bear24rw/sggoc/doc/weekly_updates/update_02_20121012.tex

\documentclass[12pt]{article}
\usepackage[margin=0.75in]{geometry}
\usepackage{titling}
\usepackage[compact]{titlesec}
\usepackage{url}
\usepackage[pdfborder={0 0 0}]{hyperref}

\setlength{\droptitle}{-4em}
\addtolength{\droptitle}{-4pt}

\title{Sega Game Gear on a Chip \\ Weekly Update \#2}
\author{ Max Thrun | Samir Silbak }

\begin{document}
\maketitle

\section*{Accomplished}
\begin{itemize}
    \item Continued work on UART ROM flasher to load game roms into the flash memory chip.
    \item Continued work on VGA timing module.
\end{itemize}

\section*{Planned}
\begin{itemize}
    \item Finish UART ROM flasher.
    \item Look into the Sega Memory Mapper\cite{mapper} functionality and start writing a module to reimplement it.
    \item Finish the VGA timing  module.
\end{itemize}

\section*{Outstanding Issues}
None at this time.

\vspace{.1in}
\begin{thebibliography}{9}
    \bibitem{mapper} \url{http://www.smspower.org/Development/Mappers?from=Development.Mapper}
\end{thebibliography}

\end{document}
