bear24rw/sggoc/doc/final_proposal_joined.pdf

## Final Project Proposal

Max Thrun — Samir Silbak

October 26, 2012

## Project Title

Sega Game Gear on a Chip (SGGoC)

## Problem Statement

As computer systems age it is often impossible to keep physically maintaining them. For many old systems you cannot buy replacement parts and finding people who have the skill to repair the original hardware is difficult. Recently, with the advent of Field Programmable Gate Arrays (FPGAs), it is now possible to completely recreate all the original hardware and reimplement everything in a hardware description language (HDL). The advantages of doing this is that you can replace a huge multi chip solution with a single chip implementation. Doing so also helps future-proof the system as the HDL is portable and standardized. Our project is a case study in the process of reimplementing the Sega Game Gear gaming console, which can be viewed as a specialized computer system, in HDL on a FPGA. From our project we hope to educate and provide people with a case study on the process and implementation strategies that go into recreating these old computer systems.

## Project Requirements

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

## Functional Description

Our final implementation will be a fully functioning Sega Game Gear running on an Altera DE-1 FPGA development board. Video output will be to a computer monitor via VGA and input will be through some type of retro gaming controller, such as the Sega Genesis controllers. Any Sega Game Gear ROM which uses the Sega mapper (we do not plan on implementing less common mappers) will be playable. Functional diagrams showing the interaction of the submodules as well the high level interaction with the user is shown on the following pages.

## Team Participants

Max Thrun - FPGAs / computer architecture / programming
Samir Silbak - Linux / embedded systems / software development

## Advisor

Carla Purdy (carla.purdy@uc.edu)

1

## SGGoC External Block Diagram

### SGGoC

Computer Monitor | Speakers | Sega Controller

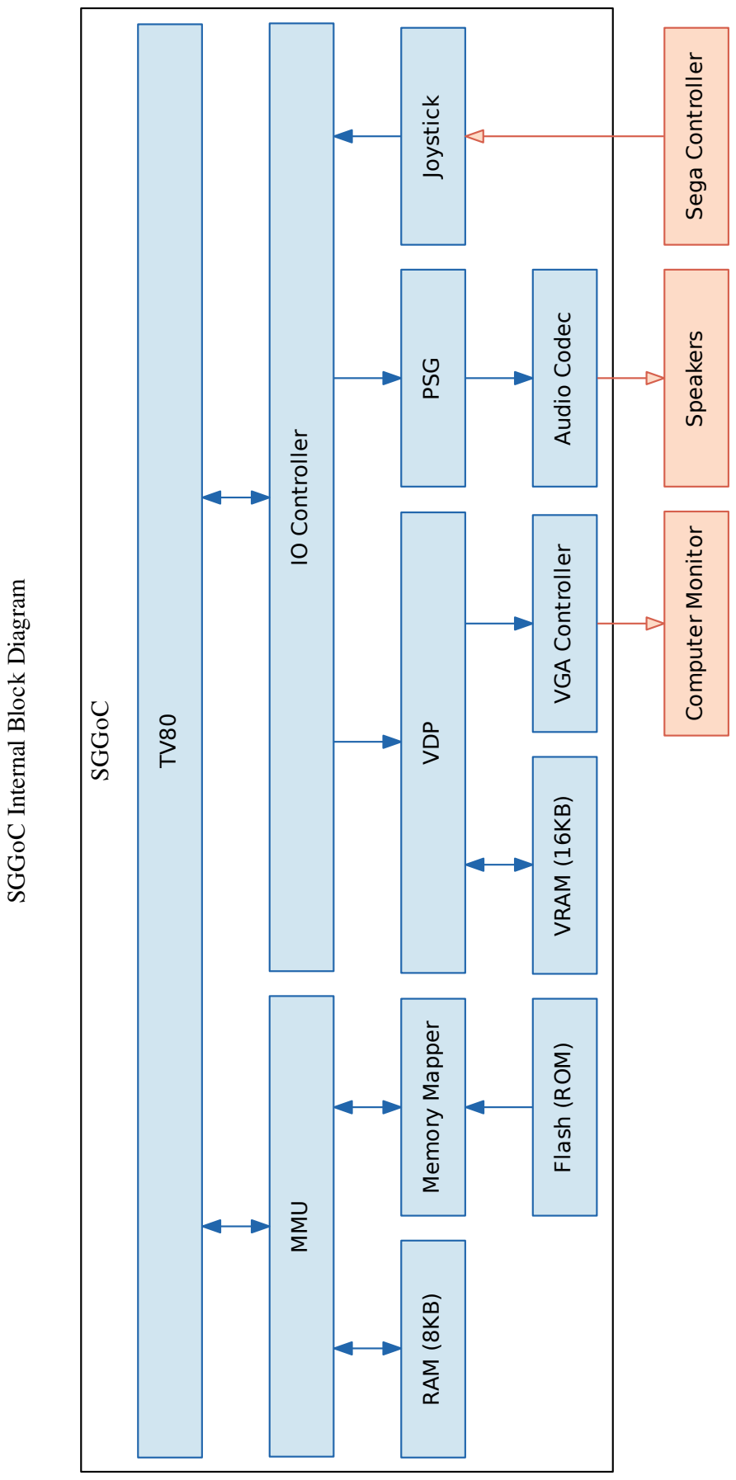
[picture p25: figure]
SGGoC Internal Block Diagram; SGGoC; MMU IO Controller; Flash (ROM) VGA Controller VRAM (16KB); Computer Monitor; Audio Codec; Sega Controller Speakers

Memory Mapper RAM (8KB) Joystick PSG VDP

Today's Date: Tuesday

(vertical red line)

Project Lead:

Start Date: Monday

[42] First Day of Week (Mon=2): 2

WBS Tasks

Task

Lead Start End

### 1 Research 10/1/12 10/6/12 6 99% 5 5 1

1.1

Find and gather

technical information on

the Game Gear

Hardware Max, Samir 10/1/12 10/1/12 1 95% 1 0 1

1.2

Determine how to

interface with Flash

memory Max 10/2/12 10/3/12 2 100% 2 2 0

1.3

Determine how to

interface with VGA Samir 10/4/12 10/5/12 2 100% 2 2 0

1.4 Start GitHub Project Max, Samir 10/6/12 10/6/12 1 100% 0 1 0

### 2 Implementation 10/6/12 11/13/12 39 11% 27 4 35

2.1 UART ROM flasher Max 10/6/12 10/8/12 3 100% 1 3 0

2.2 VGA timing module Samir 10/9/12 10/10/12 2 50% 2 1 1
2.3 Sega Memory Mapper 10/11/12 10/13/12 3 5% 2 0 3

2.4 Video Display Processor 10/15/12 11/13/12 30 0% 22 0 30 10/23/2012

Max Thrun, Samir Silbak

10/1/2012

Gantt Chart Template by Vertex42.com © 2008 Vertex42 LLC
