bear24rw/sggoc/doc/design_report/cover.pdf

### SECS Senior Design

Sega Game Gear on a Chip
Final Design Report

Date: 19/04/2013

University of Cincinnati, Ohio
