bear24rw/sggoc/doc/first_tdr_slides/design_slides.pdf

## Sega Game Gear on a Chip

Max Thrun — Samir Silbak

University of Cincinnati

Fall 2012

Sega Game Gear on a Chip | 1 / 27

## Agenda

- Introduction / Problem Description
- The Sega Game Gear
- Prototyping Platform
- Design Strategy & Process
- Component Descriptions
- Testing Strategy / Assessment Metrics
- Issues of Concern
Sega Game Gear on a Chip | Agenda | 2 / 27

## Underlying Goal

## Reimplement all the digital components of a legacy computer system in a FPGA

Sega Game Gear on a Chip | Introduction | 3 / 27

## Purpose

Why?
- Maintainability - You can no longer buy parts to service legacy computer systems

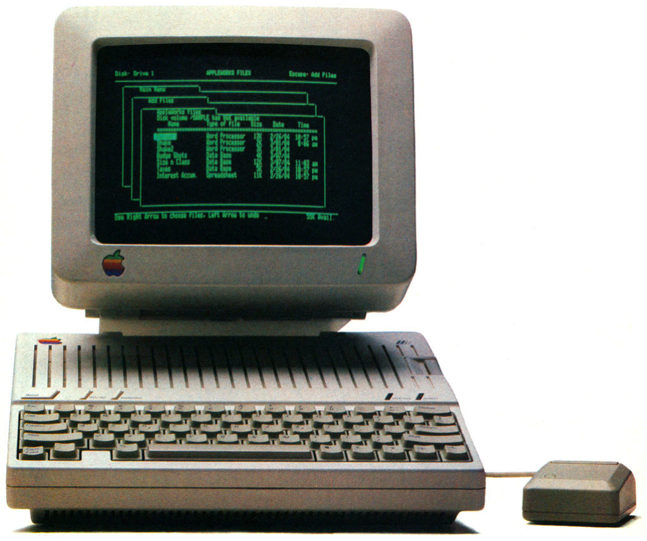
[picture p39: figure]

- Upgradability - Reimplementation gives an opportunity to add additional features
- Portability - Do not need all the original big clunky hardware. Reimplementation can be embedded in new designs
Sega Game Gear on a Chip | Introduction | 4 / 27

## Purpose

Why?
- Maintainability - You can no longer buy parts to service legacy computer systems
- Upgradability - Reimplementation gives an opportunity to add additional features
- Portability - Do not need all the original big clunky hardware. Reimplementation can be embedded in new designs
Sega Game Gear on a Chip | Introduction | 4 / 27

## Purpose

Why?
- Maintainability - You can no longer buy parts to service legacy computer systems
- Upgradability - Reimplementation gives an opportunity to add additional features
- Portability - Do not need all the original big clunky hardware. Reimplementation can be embedded in new designs
Sega Game Gear on a Chip | Introduction | 4 / 27

## Purpose

Why?
- Maintainability - You can no longer buy parts to service legacy computer systems
- Upgradability - Reimplementation gives an opportunity to add additional features
- Portability - Do not need all the original big clunky hardware. Reimplementation can be embedded in new designs
Sega Game Gear on a Chip | Introduction | 4 / 27

## Sega Game Gear

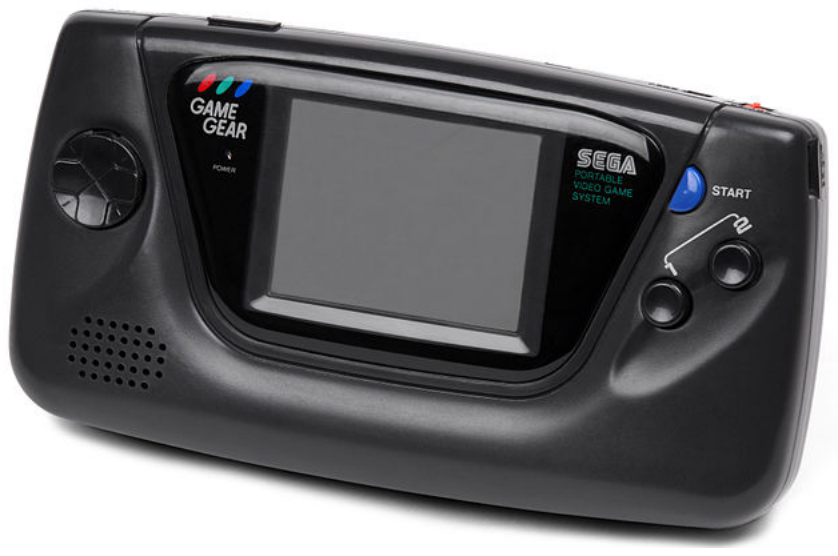
[picture p40: figure]

Sega Game Gear on a Chip | Sega Game Gear | 5 / 27

## Sega Game Gear

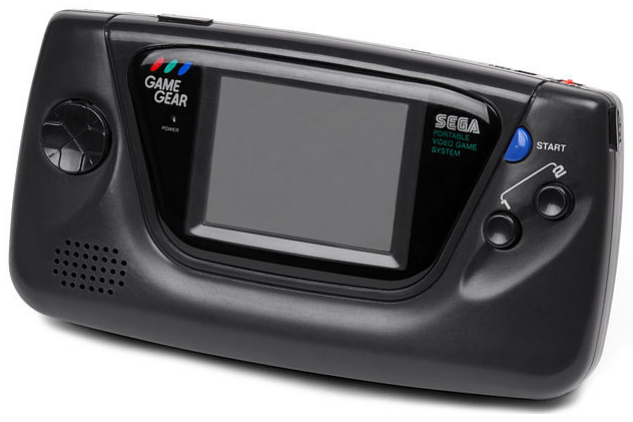
[picture p41: figure]

- Released April 1990
- Mobile version of the Sega Master System (functionally identical)
- Standard system architecture for the time (Z80 CPU, tri-state buses, etc...)
Sega Game Gear on a Chip | Sega Game Gear | 6 / 27

## Sega Master System PCB

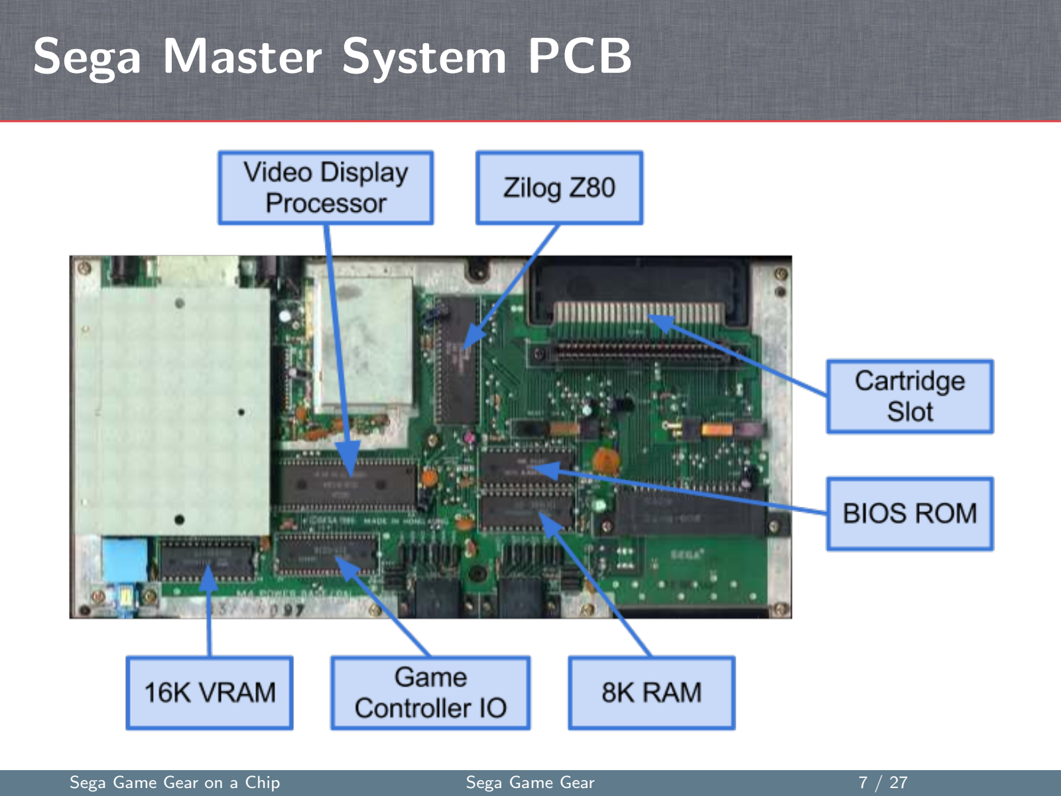
[picture p42: page 10]

Sega Game Gear on a Chip | Sega Game Gear | 7 / 27

## Black Box Diagram

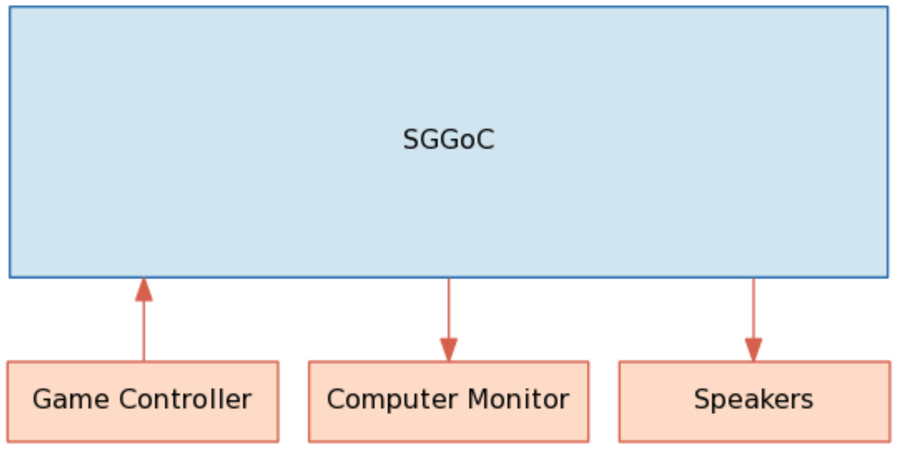
[picture p43: figure]

Sega Game Gear on a Chip | Sega Game Gear | 8 / 27

## Transparent Box Diagram

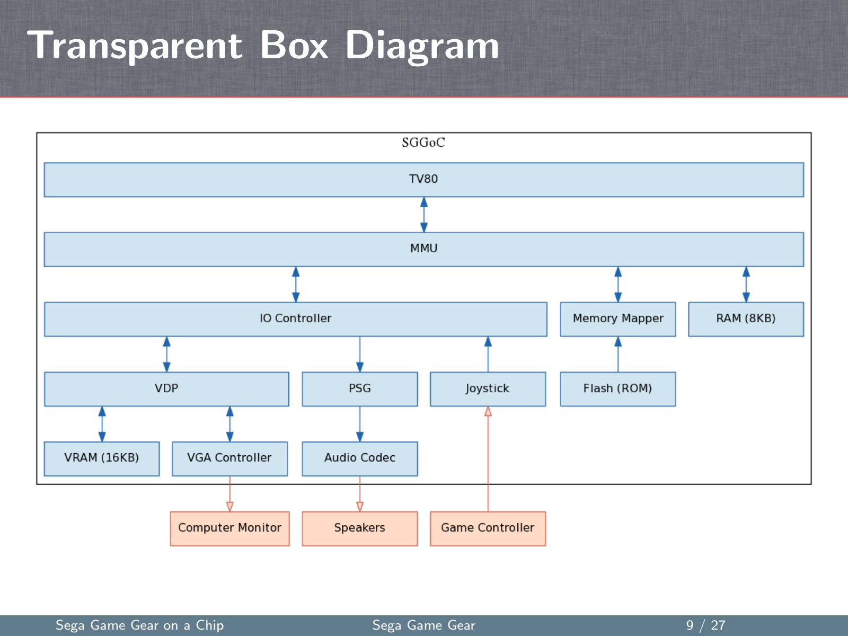
[picture p44: page 12]

Sega Game Gear on a Chip | Sega Game Gear | 9 / 27

## FPGA Development Board

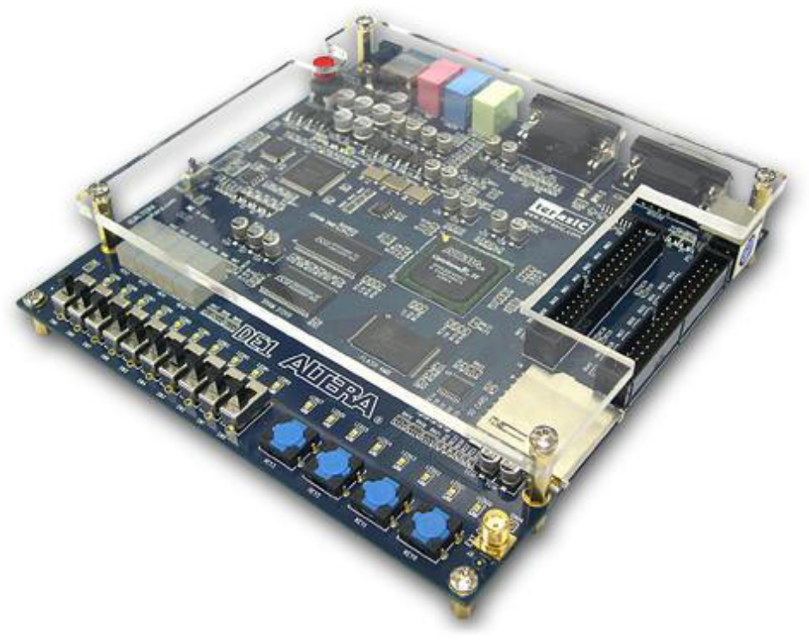
[picture p45: figure]

Sega Game Gear on a Chip | Prototyping Platform | 10 / 27

## Altera DE1

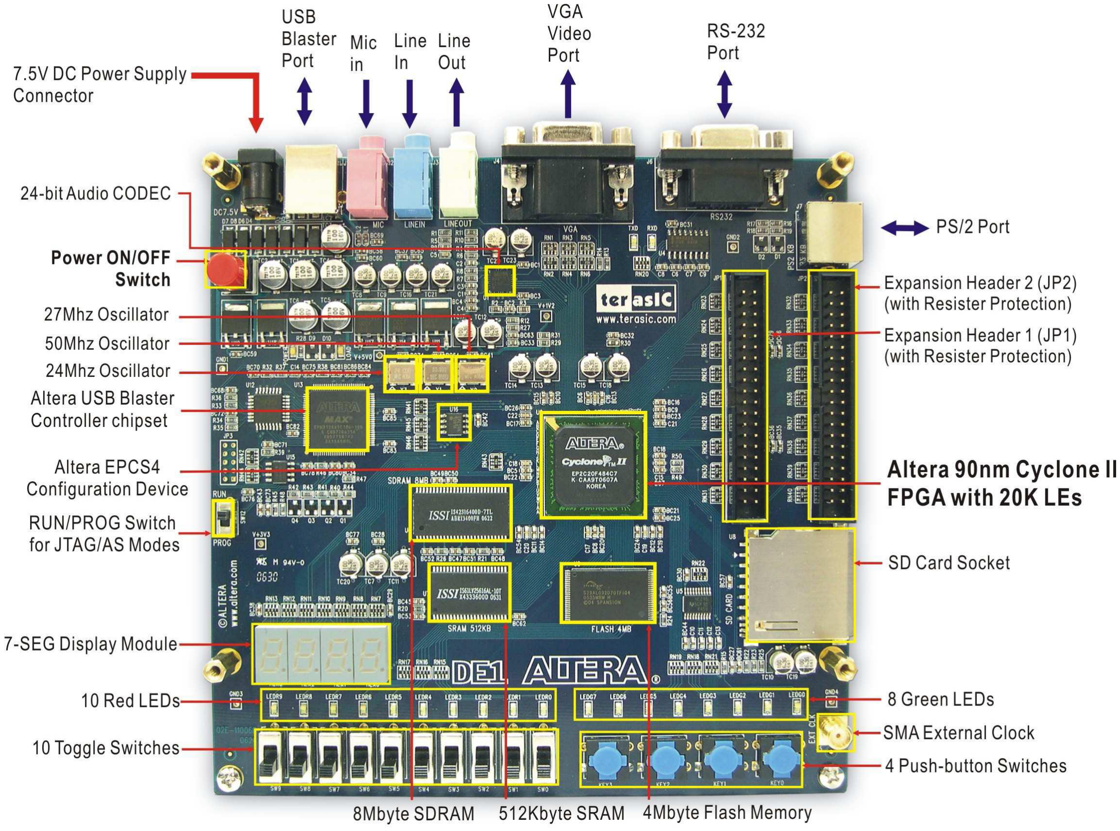
[picture p46: figure]

- Cyclone II EP2C20F484C7
- VGA, Audio, SD Card, 4 MB Flash
- Supports a familiar command line development environment
- Extremely good documentation
Sega Game Gear on a Chip | Prototyping Platform | 11 / 27

## Design Strategy

1. Break down system components according to the original system architecture
2. Implement each component to match the original functionality described by official and non official documents
3. Test each components functionality against the actual hardware (in our case an emulator)
4. Tie components together in a way that is better suited toward FPGA technology (E.g. avoid tri-state buses)
Sega Game Gear on a Chip | Design Strategy | 12 / 27

## Design Strategy

1. Break down system components according to the original system architecture
2. Implement each component to match the original functionality described by official and non official documents
3. Test each components functionality against the actual hardware (in our case an emulator)
4. Tie components together in a way that is better suited toward FPGA technology (E.g. avoid tri-state buses)
Sega Game Gear on a Chip | Design Strategy | 12 / 27

## Design Strategy

1. Break down system components according to the original system architecture
2. Implement each component to match the original functionality described by official and non official documents
3. Test each components functionality against the actual hardware (in our case an emulator)
4. Tie components together in a way that is better suited toward FPGA technology (E.g. avoid tri-state buses)
Sega Game Gear on a Chip | Design Strategy | 12 / 27

## Design Strategy

1. Break down system components according to the original system architecture
2. Implement each component to match the original functionality described by official and non official documents
3. Test each components functionality against the actual hardware (in our case an emulator)
4. Tie components together in a way that is better suited toward FPGA technology (E.g. avoid tri-state buses)
Sega Game Gear on a Chip | Design Strategy | 12 / 27

## Game Cartridge

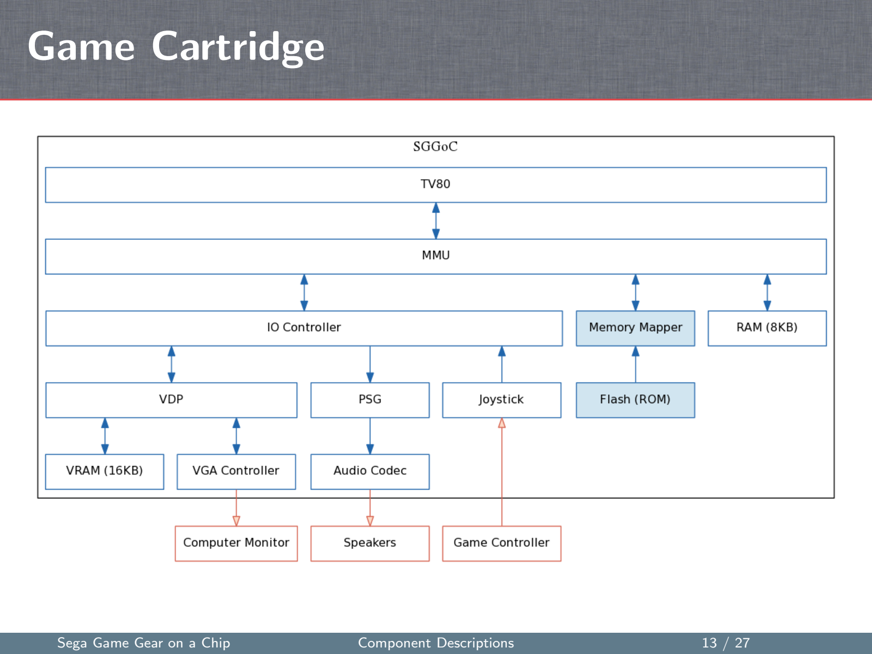
[picture p47: page 19]

Sega Game Gear on a Chip | Component Descriptions | 13 / 27

## Game Cartridge

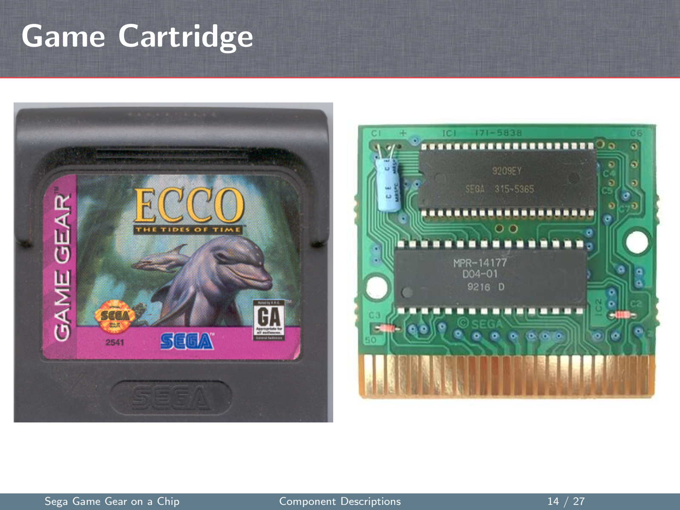
[picture p48: page 20]

## Game Cartridge

Each game cartridge made up of at least two components:
- Game data ROM
- Memory Mapper

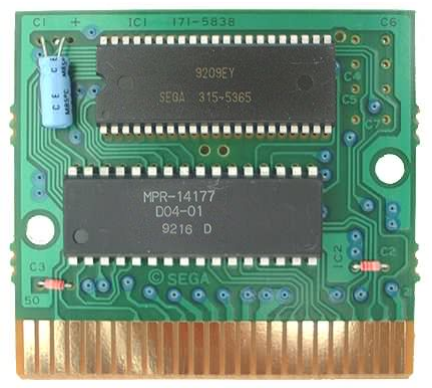
[picture p49: figure]

Practically every game ROM has been dumped as is available online

## Game Cartridge

Each game cartridge made up of at least two components:
- Game data ROM
- Memory Mapper

Practically every game ROM has been dumped as is available online

## Game Cartridge

Each game cartridge made up of at least two components:
- Game data ROM
- Memory Mapper

Practically every game ROM has been dumped as is available online

## Game Cartridge

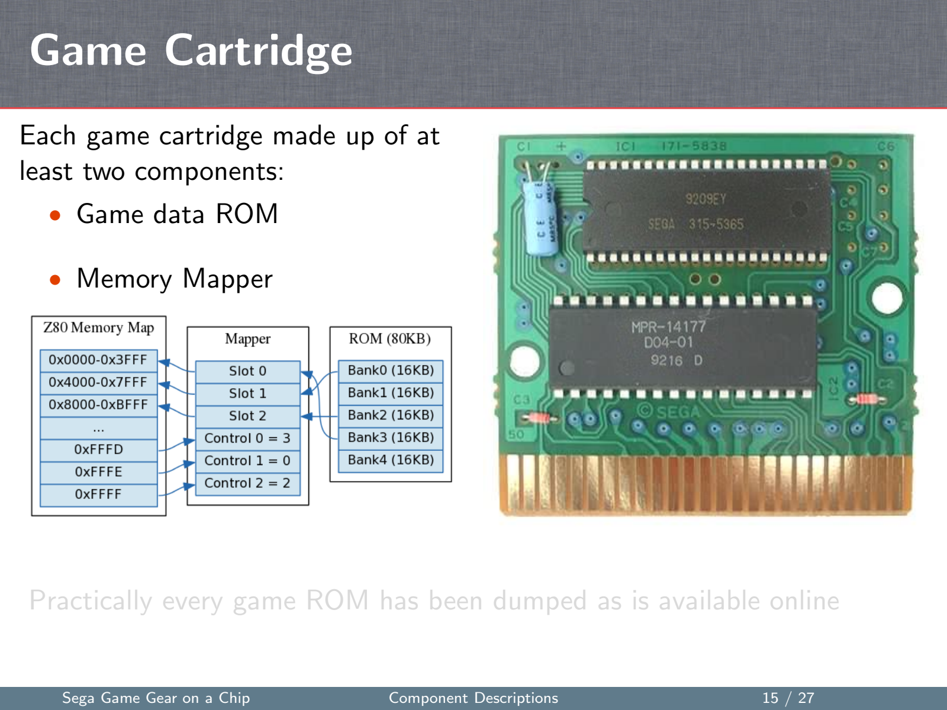
[picture p50: page 24]

Each game cartridge made up of at least two components:
- Game data ROM
- Memory Mapper

Practically every game ROM has been dumped as is available online

## Game Cartridge

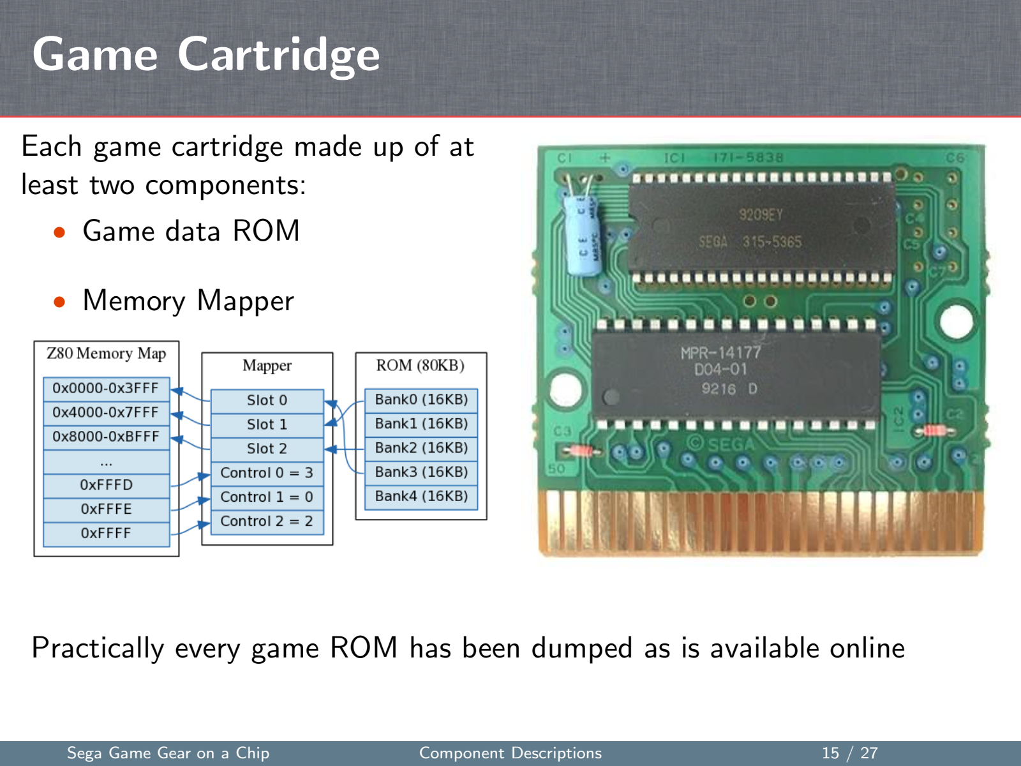
[picture p51: page 25]

Each game cartridge made up of at least two components:
- Game data ROM
- Memory Mapper

Practically every game ROM has been dumped as is available online

## Storing Game ROMs

A few options to store game ROMs:
1. Hookup the actual cartridge
- Straight forward
- Don’t have to re-implement the memory mappers
- Defeats most of the point of the project
2. Store them on a SD card
- Extremely portable / convenient
- Complicated interface
3. Store them on the 4MB flash chip on the DE1
- Fairly straightforward
- Extremely non-portable
- Flash chip looks just like original ROM chips

## Storing Game ROMs

A few options to store game ROMs:
1. Hookup the actual cartridge
- Straight forward
- Don’t have to re-implement the memory mappers
- Defeats most of the point of the project
2. Store them on a SD card
- Extremely portable / convenient
- Complicated interface
3. Store them on the 4MB flash chip on the DE1
- Fairly straightforward
- Extremely non-portable
- Flash chip looks just like original ROM chips

## Storing Game ROMs

A few options to store game ROMs:
1. Hookup the actual cartridge
- Straight forward
- Don’t have to re-implement the memory mappers
- Defeats most of the point of the project
2. Store them on a SD card
- Extremely portable / convenient
- Complicated interface
3. Store them on the 4MB flash chip on the DE1
- Fairly straightforward
- Extremely non-portable
- Flash chip looks just like original ROM chips

## Storing Game ROMs

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

## Storing Game ROMs

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

## Storing Game ROMs

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

## Storing Game ROMs

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

## Storing Game ROMs

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

## Storing Game ROMs

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

## Storing Game ROMs

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

## Storing Game ROMs

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

## Storing Game ROMs

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

## Storing Game ROMs

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

## Storing Game ROMs

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

## ROM Flasher Tool

Need a tool to load a ROM file into the flash chip from the PC

1. Load RS232-to-Flash bridge into the FPGA
2. PC waits for FPGA to request a byte
3. PC sends the next byte of ROM file
4. FPGA writes byte to flash
5. Go back to 2

Can also do the reverse to read back and verify the flash contents against the ROM file

## ROM Flasher Tool

Need a tool to load a ROM file into the flash chip from the PC

1. Load RS232-to-Flash bridge into the FPGA
2. PC waits for FPGA to request a byte
3. PC sends the next byte of ROM file
4. FPGA writes byte to flash
5. Go back to 2

Can also do the reverse to read back and verify the flash contents against the ROM file

## ROM Flasher Tool

Need a tool to load a ROM file into the flash chip from the PC

1. Load RS232-to-Flash bridge into the FPGA
2. PC waits for FPGA to request a byte
3. PC sends the next byte of ROM file
4. FPGA writes byte to flash
5. Go back to 2

Can also do the reverse to read back and verify the flash contents against the ROM file

## ROM Flasher Tool

Need a tool to load a ROM file into the flash chip from the PC

1. Load RS232-to-Flash bridge into the FPGA
2. PC waits for FPGA to request a byte
3. PC sends the next byte of ROM file
4. FPGA writes byte to flash
5. Go back to 2

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

## ROM Flasher Tool

Need a tool to load a ROM file into the flash chip from the PC

1. Load RS232-to-Flash bridge into the FPGA
2. PC waits for FPGA to request a byte
3. PC sends the next byte of ROM file
4. FPGA writes byte to flash
5. Go back to 2

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

## ROM Flasher Tool

Need a tool to load a ROM file into the flash chip from the PC

1. Load RS232-to-Flash bridge into the FPGA
2. PC waits for FPGA to request a byte
3. PC sends the next byte of ROM file
4. FPGA writes byte to flash
5. Go back to 2

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

## ROM Flasher Tool

Need a tool to load a ROM file into the flash chip from the PC

1. Load RS232-to-Flash bridge into the FPGA
2. PC waits for FPGA to request a byte
3. PC sends the next byte of ROM file
4. FPGA writes byte to flash
5. Go back to 2

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

## ROM Flasher Tool

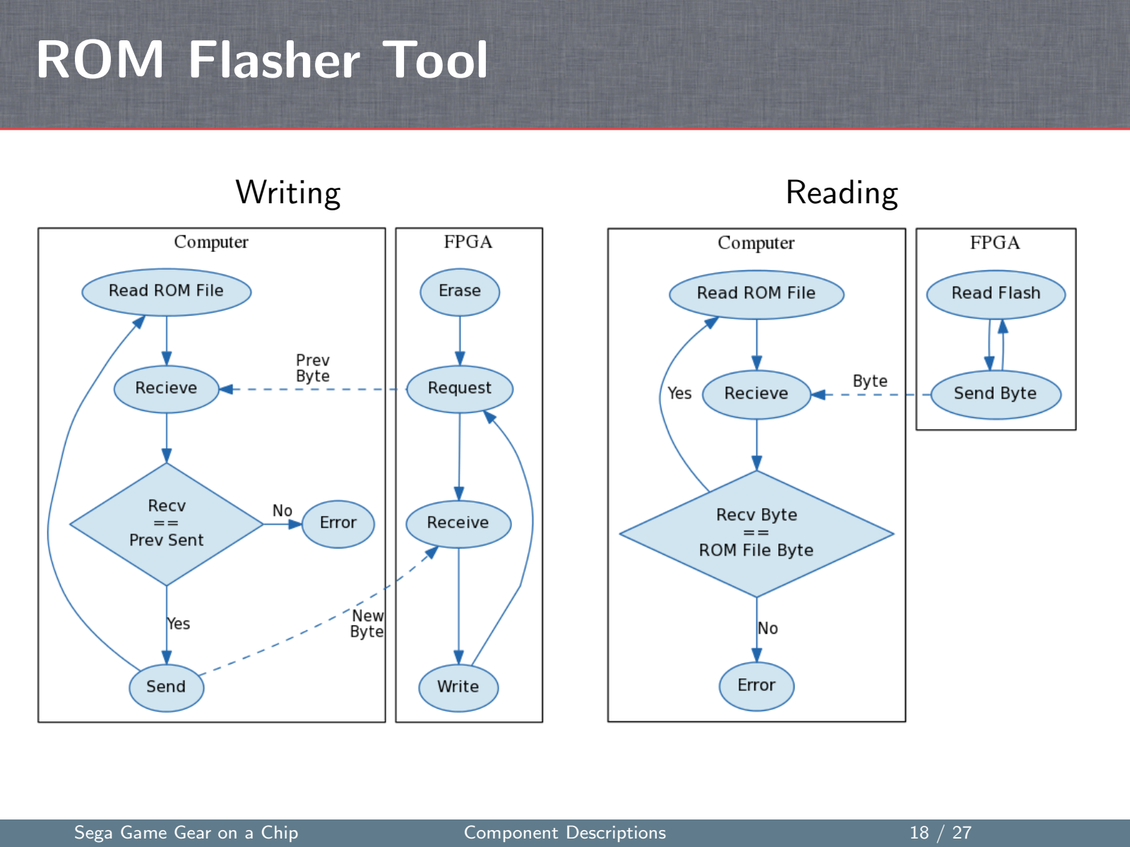
[picture p52: page 47]

Writing | Reading

## Zilog Z80

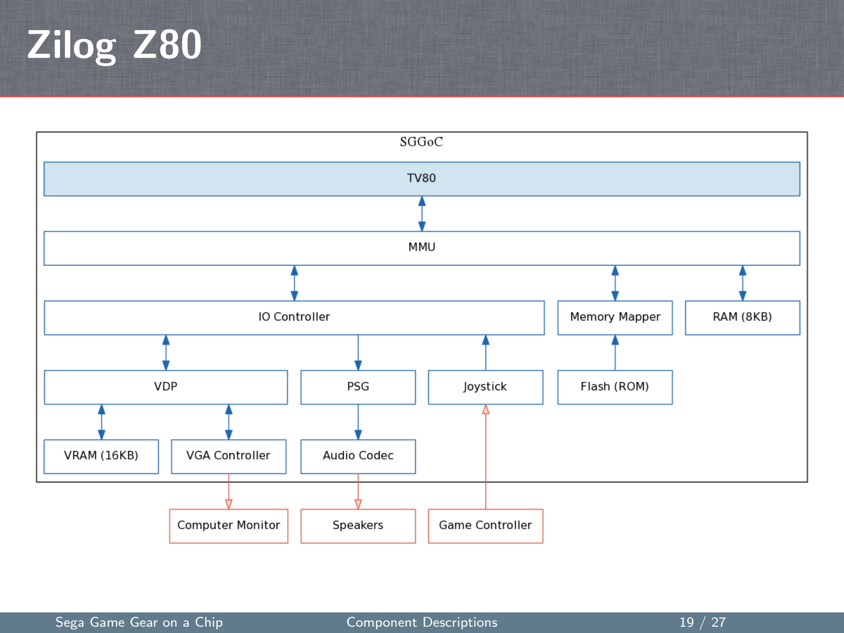
[picture p53: page 48]

## Zilog Z80

- Implementing a Zilog Z80 is totally outside the scope of this project
- Numerous implementations available online for free
- TV80 is an open source, proven, cycle accurate Z80
implementation written in
Verilog

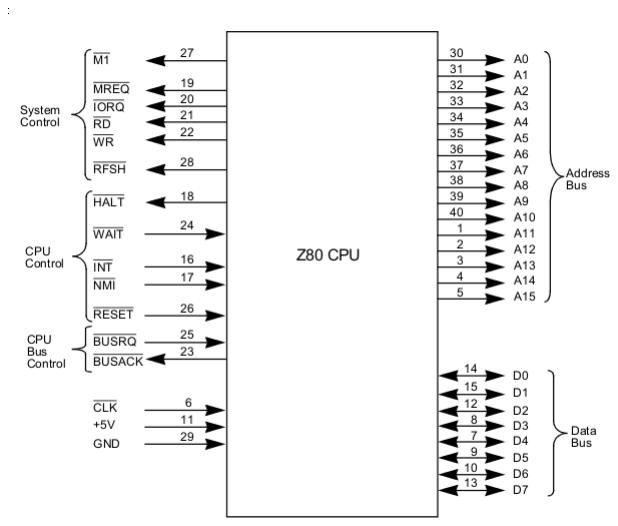
[picture p54: figure]

http://opencores.org/project,tv80

## Zilog Z80

- Implementing a Zilog Z80 is totally outside the scope of this project
- Numerous implementations available online for free
- TV80 is an open source, proven, cycle accurate Z80
implementation written in
Verilog

http://opencores.org/project,tv80

## Zilog Z80

- Implementing a Zilog Z80 is totally outside the scope of this project
- Numerous implementations available online for free
- TV80 is an open source, proven, cycle accurate Z80
implementation written in
Verilog

http://opencores.org/project,tv80

## System and Video RAM

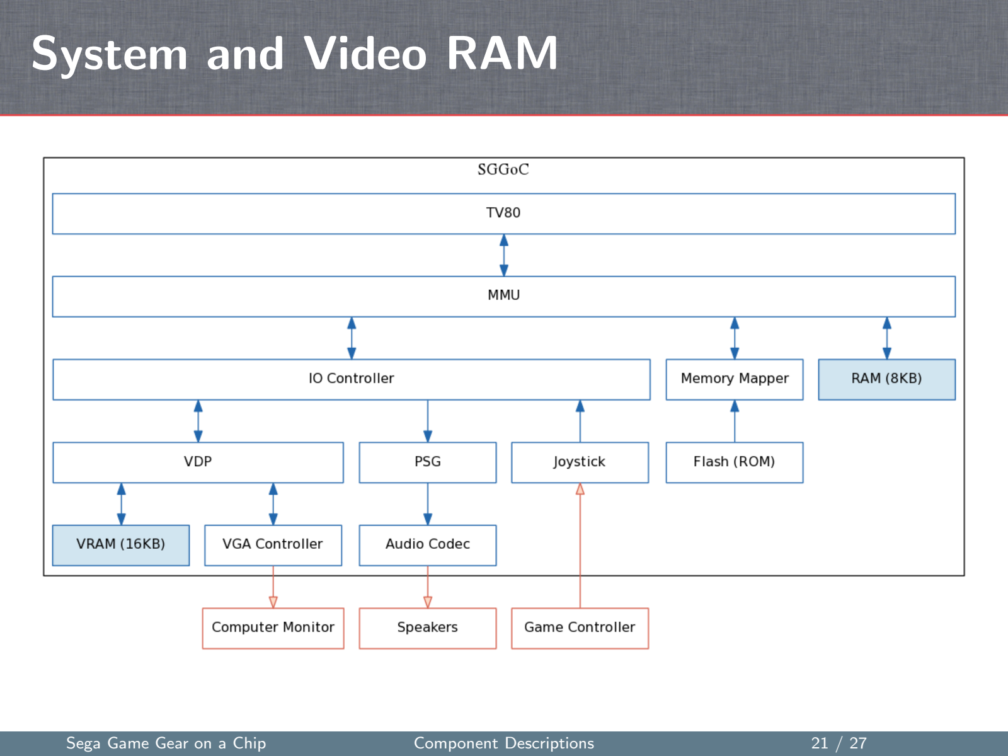
[picture p55: page 52]

## System and Video RAM

- Most modern FPGAs have more internal RAM than legacy systems
- Cyclon II has enough internal block RAM (30KB) to fit both system and video RAM
- Design Strategy: Write code that implies generic block RAM as opposed to device specific primitives to increase portability of codebase

http://danstrother.com/2010/09/11/inferring-rams-in-fpgas/

## System and Video RAM

- Most modern FPGAs have more internal RAM than legacy systems
- Cyclon II has enough internal block RAM (30KB) to fit both system and video RAM
- Design Strategy: Write code that implies generic block RAM as opposed to device specific primitives to increase portability of codebase

http://danstrother.com/2010/09/11/inferring-rams-in-fpgas/

## System and Video RAM

- Most modern FPGAs have more internal RAM than legacy systems
- Cyclon II has enough internal block RAM (30KB) to fit both system and video RAM
- Design Strategy: Write code that implies generic block RAM as opposed to device specific primitives to increase portability of codebase

http://danstrother.com/2010/09/11/inferring-rams-in-fpgas/

## Video Display Processor (VDP)

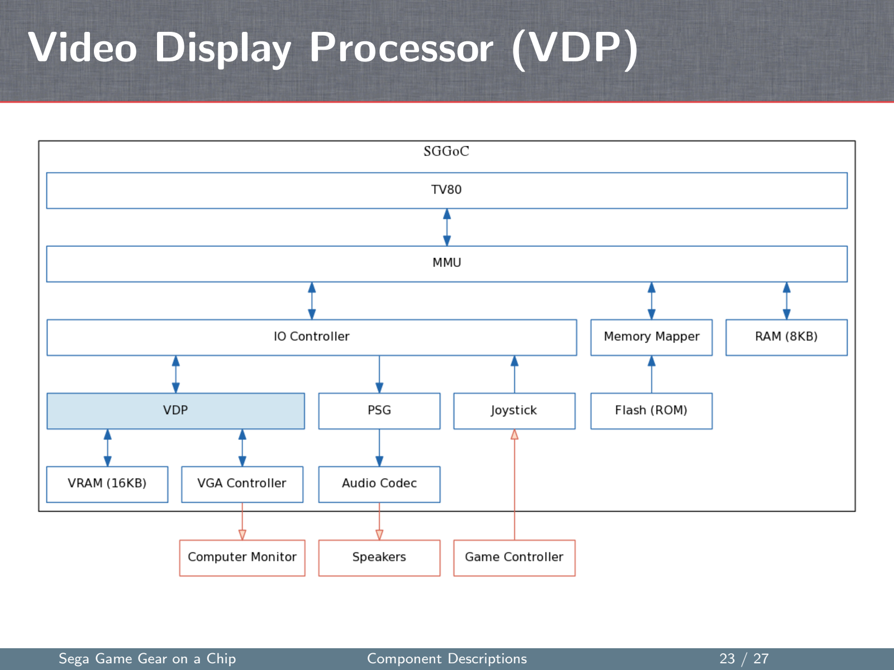
[picture p56: page 56]

## Video Display Processor (VDP)

- Texas Instruments TMS9918a
- Used in a number of legacy systems but no good HDL implementation exists online
- Meant to drive CRTs so functionality maps perfectly to the VGA interface on the DE1
- Communicates with the Z80 as an IO device

http://en.wikipedia.org/wiki/Texas_Instruments_TMS9918

## Video Display Processor (VDP)

- Texas Instruments TMS9918a
- Used in a number of legacy systems but no good HDL implementation exists online
- Meant to drive CRTs so functionality maps perfectly to the VGA interface on the DE1
- Communicates with the Z80 as an IO device

http://en.wikipedia.org/wiki/Texas_Instruments_TMS9918

## Video Display Processor (VDP)

- Texas Instruments TMS9918a
- Used in a number of legacy systems but no good HDL implementation exists online
- Meant to drive CRTs so functionality maps perfectly to the VGA interface on the DE1
- Communicates with the Z80 as an IO device

http://en.wikipedia.org/wiki/Texas_Instruments_TMS9918

## Video Display Processor (VDP)

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

http://en.wikipedia.org/wiki/Texas_Instruments_TMS9918

## Testing Strategy

Game Gear is hard to test/verify
- Its only output is video (no UART, JTAG, etc..)
- Most documentation is 3rd party

Our strategy:

1. Use an emulator to watch memory fetches and get memory dumps
2. Initialize our RAMs with these dumps and verify we achieve the same visual output
3. Watch instruction fetches with a logic analyzer and see if they match the emulator

Could replace emulator with a logic/bus analyzer connected to the original hardware

Sega Game Gear on a Chip | Testing Strategy | 25 / 27

## Testing Strategy

Game Gear is hard to test/verify
- Its only output is video (no UART, JTAG, etc..)
- Most documentation is 3rd party

Our strategy:

1. Use an emulator to watch memory fetches and get memory dumps
2. Initialize our RAMs with these dumps and verify we achieve the same visual output
3. Watch instruction fetches with a logic analyzer and see if they match the emulator

Could replace emulator with a logic/bus analyzer connected to the original hardware

Sega Game Gear on a Chip | Testing Strategy | 25 / 27

## Testing Strategy

Game Gear is hard to test/verify
- Its only output is video (no UART, JTAG, etc..)
- Most documentation is 3rd party

Our strategy:

1. Use an emulator to watch memory fetches and get memory dumps
2. Initialize our RAMs with these dumps and verify we achieve the same visual output
3. Watch instruction fetches with a logic analyzer and see if they match the emulator

Could replace emulator with a logic/bus analyzer connected to the original hardware

Sega Game Gear on a Chip | Testing Strategy | 25 / 27

## Testing Strategy

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

Our strategy:

1. Use an emulator to watch memory fetches and get memory dumps
2. Initialize our RAMs with these dumps and verify we achieve the same visual output
3. Watch instruction fetches with a logic analyzer and see if they match the emulator

Could replace emulator with a logic/bus analyzer connected to the original hardware

Sega Game Gear on a Chip | Testing Strategy | 25 / 27

## Testing Strategy

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

Our strategy:

1. Use an emulator to watch memory fetches and get memory dumps
2. Initialize our RAMs with these dumps and verify we achieve the same visual output
3. Watch instruction fetches with a logic analyzer and see if they match the emulator

Could replace emulator with a logic/bus analyzer connected to the original hardware

Sega Game Gear on a Chip | Testing Strategy | 25 / 27

## Testing Strategy

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

Our strategy:

1. Use an emulator to watch memory fetches and get memory dumps
2. Initialize our RAMs with these dumps and verify we achieve the same visual output
3. Watch instruction fetches with a logic analyzer and see if they match the emulator

Could replace emulator with a logic/bus analyzer connected to the original hardware

Sega Game Gear on a Chip | Testing Strategy | 25 / 27

## Testing Strategy

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

Our strategy:

1. Use an emulator to watch memory fetches and get memory dumps
2. Initialize our RAMs with these dumps and verify we achieve the same visual output
3. Watch instruction fetches with a logic analyzer and see if they match the emulator

Could replace emulator with a logic/bus analyzer connected to the original hardware

Sega Game Gear on a Chip | Testing Strategy | 25 / 27

## Testing Strategy

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

Our strategy:

1. Use an emulator to watch memory fetches and get memory dumps
2. Initialize our RAMs with these dumps and verify we achieve the same visual output
3. Watch instruction fetches with a logic analyzer and see if they match the emulator

Could replace emulator with a logic/bus analyzer connected to the original hardware

Sega Game Gear on a Chip | Testing Strategy | 25 / 27

## Issues of Concern

- Each component is tightly dependant on each other. Need to implement each one correctly for whole system to function.
- If something doesn’t work we cannot simply change the design spec. We are working against an established spec that cannot be changed.
Sega Game Gear on a Chip | Issues of Concern | 26 / 27

# Questions?

Sega Game Gear on a Chip | Issues of Concern | 27 / 27
