bear24rw/sggoc/doc/objective_tree.pdf

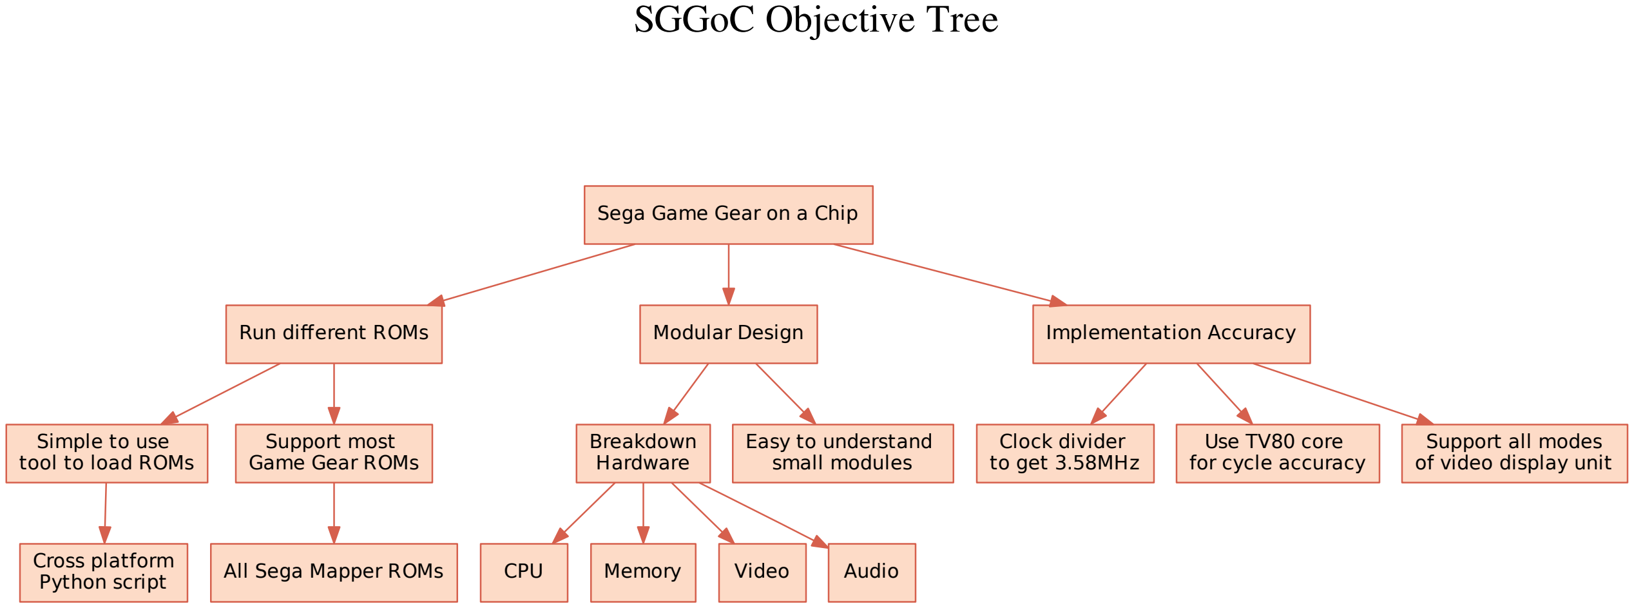
[picture p57: figure]
SGGoC Objective Tree; Sega Game Gear on a Chip; Run different ROMs; Modular Design; Implementation Accuracy; Simple to use tool to load ROMs; Support most Game Gear ROMs; Breakdown Hardware; Easy to understand small modules; Clock divider to get 3.58MHz; Use TV80 core for cycle accuracy; Support all modes of video display unit; Cross platform; Python script; All Sega Mapper ROMs; CPU; Memory; Video; Audio
