bear24rw/sggoc/doc/final_tdr/final_tdr.pdf

## Sega Game Gear on a Chip

Max Thrun | Samir Silbak

University of Cincinnati

Fall 2012

Max Thrun | Samir Silbak (University of | Cincinnati) Sega Game Gear on a Chip | Fall 2012 | 1 / 25

## Agenda

- Problem Description
- Design Process
- Implementation Priority
- Requirements
- Assessment Metrics
- Test Plans
- Design Overview
- Project Limitations
- Demonstration
Max Thrun | Samir Silbak (University of | Cincinnati) Sega Game Gear on a Chip | Fall 2012 | 2 / 25

## Problem Description

## Reimplement all the digital components of a legacy computer system in a FPGA

Max Thrun | Samir Silbak (University of | Cincinnati) Sega Game Gear on a Chip | Fall 2012 | 3 / 25

## Problem Description

Why?
- Maintainability - You can no longer buy parts to service legacy computer systems


- Upgradability - Reimplementation gives an opportunity to add additional features
- Portability - Do not need all the original big clunky hardware. Reimplementation can be embedded in new designs
Max Thrun | Samir Silbak (University of | Cincinnati) Sega Game Gear on a Chip | Fall 2012 | 4 / 25

## Problem Description

Why?
- Maintainability - You can no longer buy parts to service legacy computer systems
- Upgradability - Reimplementation gives an opportunity to add additional features
- Portability - Do not need all the original big clunky hardware. Reimplementation can be embedded in new designs
Max Thrun | Samir Silbak (University of | Cincinnati) Sega Game Gear on a Chip | Fall 2012 | 4 / 25

## Problem Description

Why?
- Maintainability - You can no longer buy parts to service legacy computer systems
- Upgradability - Reimplementation gives an opportunity to add additional features
- Portability - Do not need all the original big clunky hardware. Reimplementation can be embedded in new designs
Max Thrun | Samir Silbak (University of | Cincinnati) Sega Game Gear on a Chip | Fall 2012 | 4 / 25

## Problem Description

Why?
- Maintainability - You can no longer buy parts to service legacy computer systems
- Upgradability - Reimplementation gives an opportunity to add additional features
- Portability - Do not need all the original big clunky hardware. Reimplementation can be embedded in new designs
Max Thrun | Samir Silbak (University of | Cincinnati) Sega Game Gear on a Chip | Fall 2012 | 4 / 25

## Design Process

1. Break down system components according to the original system architecture
2. Implement each component in Verilog matching the original functionality described by official and non official documents
3. Simulate each components functionality and compare it against the actual hardware (in our case an emulator)
4. Tie components together in a way that is better suited toward FPGA technology (E.g. avoid tri-state buses)
Max Thrun | Samir Silbak (University of | Cincinnati) Sega Game Gear on a Chip | Fall 2012 | 5 / 25

## Design Process

1. Break down system components according to the original system architecture
2. Implement each component in Verilog matching the original functionality described by official and non official documents
3. Simulate each components functionality and compare it against the actual hardware (in our case an emulator)
4. Tie components together in a way that is better suited toward FPGA technology (E.g. avoid tri-state buses)
Max Thrun | Samir Silbak (University of | Cincinnati) Sega Game Gear on a Chip | Fall 2012 | 5 / 25

## Design Process

1. Break down system components according to the original system architecture
2. Implement each component in Verilog matching the original functionality described by official and non official documents
3. Simulate each components functionality and compare it against the actual hardware (in our case an emulator)
4. Tie components together in a way that is better suited toward FPGA technology (E.g. avoid tri-state buses)
Max Thrun | Samir Silbak (University of | Cincinnati) Sega Game Gear on a Chip | Fall 2012 | 5 / 25

## Design Process

1. Break down system components according to the original system architecture
2. Implement each component in Verilog matching the original functionality described by official and non official documents
3. Simulate each components functionality and compare it against the actual hardware (in our case an emulator)
4. Tie components together in a way that is better suited toward FPGA technology (E.g. avoid tri-state buses)
Max Thrun | Samir Silbak (University of | Cincinnati) Sega Game Gear on a Chip | Fall 2012 | 5 / 25

## Implementation Priority

1. Flash Memory Interface
2. Memory Management Unit (MMU)
3. Z80 + System RAM
4. Cartridge Mapper
5. VGA Driver
6. Background Tiles + VRAM
7. Video Display Processor Logic (VDP)
8. Sprites
9. Controller Input
10. Sound
Max Thrun | Samir Silbak (University of | Cincinnati) Sega Game Gear on a Chip | Fall 2012 | 6 / 25

## Requirements

1. VGA Output - Need to output video via VGA which is the most common video interface found on FPGA development boards.
2. ROM Loading - Need to be able to easily load in different game and test ROMs into the Flash memory chip on the dev board.
3. Accurate Re-implementation - Overall goal of this project is to re-implement the Sega Game Gear as accurately as possible. User should not be able to tell its not the original hardware.
4. Accurate Architecture - Overall system architecture should be as clean as possible and closely match that of the original Game Gear.
Max Thrun | Samir Silbak (University of | Cincinnati) Sega Game Gear on a Chip | Fall 2012 | 7 / 25

## Requirements

1. VGA Output - Need to output video via VGA which is the most common video interface found on FPGA development boards.
2. ROM Loading - Need to be able to easily load in different game and test ROMs into the Flash memory chip on the dev board.
3. Accurate Re-implementation - Overall goal of this project is to re-implement the Sega Game Gear as accurately as possible. User should not be able to tell its not the original hardware.
4. Accurate Architecture - Overall system architecture should be as clean as possible and closely match that of the original Game Gear.
Max Thrun | Samir Silbak (University of | Cincinnati) Sega Game Gear on a Chip | Fall 2012 | 7 / 25

## Requirements

1. VGA Output - Need to output video via VGA which is the most common video interface found on FPGA development boards.
2. ROM Loading - Need to be able to easily load in different game and test ROMs into the Flash memory chip on the dev board.
3. Accurate Re-implementation - Overall goal of this project is to re-implement the Sega Game Gear as accurately as possible. User should not be able to tell its not the original hardware.
4. Accurate Architecture - Overall system architecture should be as clean as possible and closely match that of the original Game Gear.
Max Thrun | Samir Silbak (University of | Cincinnati) Sega Game Gear on a Chip | Fall 2012 | 7 / 25

## Requirements

1. VGA Output - Need to output video via VGA which is the most common video interface found on FPGA development boards.
2. ROM Loading - Need to be able to easily load in different game and test ROMs into the Flash memory chip on the dev board.
3. Accurate Re-implementation - Overall goal of this project is to re-implement the Sega Game Gear as accurately as possible. User should not be able to tell its not the original hardware.
4. Accurate Architecture - Overall system architecture should be as clean as possible and closely match that of the original Game Gear.
Max Thrun | Samir Silbak (University of | Cincinnati) Sega Game Gear on a Chip | Fall 2012 | 7 / 25

## Assessment Metrics

Function | Requirement Specification | Design
Verified

Device
Validated
VGA Output | Design must output video at
640x480 to a VGA monitor | Yes | Yes
Sega Mapper | Design must implement the
Sega Memory Mapper | Yes | Yes

Video Display
Processor

Design must implement the
TMS9918 | Partly | Partly

Game ROM
stored in flash

Design must be able to load
game ROMs from flash | Yes | Yes
Controller Input | Design must implement a
single controller | No | No

Game Gear
system
functionality

Design must implement the
same functionality as the
original Game Gear
Partly | Partly
Max Thrun | Samir Silbak (University of | Cincinnati) Sega Game Gear on a Chip | Fall 2012 | 8 / 25

## Test Plans

Test plan split up into 4 areas:

- Z80, RAM, Cartridge
- VDP Background Tile Rendering
- System Simulation vs Emulator
- Custom test ROMs
Max Thrun | Samir Silbak (University of | Cincinnati) Sega Game Gear on a Chip | Fall 2012 | 9 / 25

## Z80, RAM, Cartridge Test

Ensures basic code execution and memory/IO interfaces are working properly

1. Connect 8 LEDs to Z80 IO port 1
2. Write simple Z80 test program that increments IO port 1
3. Load test program into flash
4. Divide Z80 clock down to 10Hz
5. Verify LEDs incrementing on development board
1 | __sfr __at (0 x01 ) debug ;
2 | i n t main ( ) {
3 | debug = 0 x38 ;
4 | whil e ( 1 ) {}
5 | r e t u r n 0 ;
6 | }
Max Thrun | Samir Silbak (University of | Cincinnati) Sega Game Gear on a Chip | Fall 2012 | 10 / 25

## VDP Background Tile Rendering Test

Ensures VDP background tile rendering works correctly without worrying about Z80 or interface logic

1. Obtain VRAM dump from the Osmose
emulator
2. Verify dump integrity using rendering program on computer
3. Transfer dump to FPGA VRAM via the ‘MemSend’ tool
4. Verify that the resulting image on
screen matches the emulator

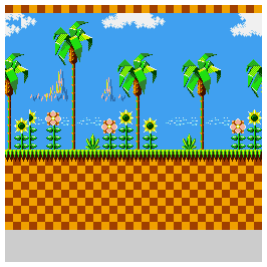
[picture p58: figure]

Max Thrun | Samir Silbak (University of | Cincinnati) Sega Game Gear on a Chip | Fall 2012 | 11 / 25

## System Simulation vs Emulator Test

Ensures that our system functionally matches a known good one

1. Insert print statements on all memory and IO accesses in emulator
2. Do the same for the Verilog system level simulation
3. Run emulator and simulation on same ROM
4. Diff the print logs
5. Verify that the memory and IO accesses match between the emulator and simulation
Max Thrun | Samir Silbak (University of | Cincinnati) Sega Game Gear on a Chip | Fall 2012 | 12 / 25

## System Simulation vs Emulator

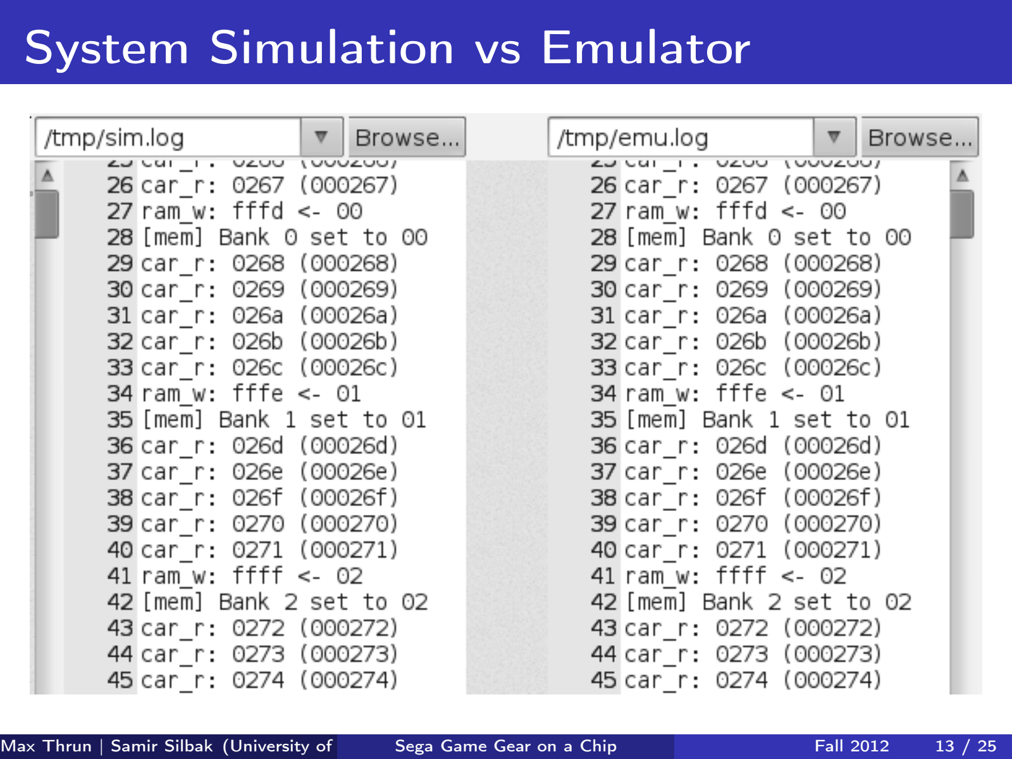
[picture p59: page 22]

Max Thrun | Samir Silbak (University of | Cincinnati) Sega Game Gear on a Chip | Fall 2012 | 13 / 25

## System Simulation vs Emulator


Max Thrun | Samir Silbak (University of | Cincinnati) Sega Game Gear on a Chip | Fall 2012 | 14 / 25

## System Simulation vs Emulator

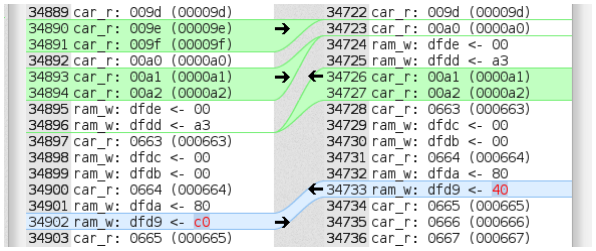
[picture p60: figure]

Max Thrun | Samir Silbak (University of | Cincinnati) Sega Game Gear on a Chip | Fall 2012 | 15 / 25

## System Simulation vs Emulator

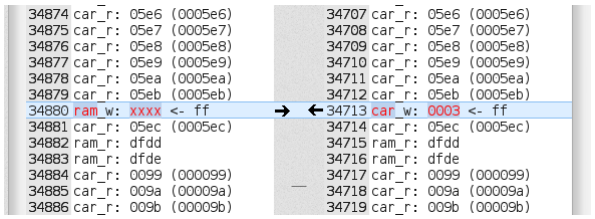
[picture p61: figure]

Max Thrun | Samir Silbak (University of | Cincinnati) Sega Game Gear on a Chip | Fall 2012 | 16 / 25

## Custom Test ROMs

Allows unit testing of specific features of the system


1. Write program that performs a certain
task (ex. scroll screen left 5 pixels)
2. Verify ROM in emulator
3. Flash ROM onto the dev board
4. Verify expected output is achived on FPGA
Max Thrun | Samir Silbak (University of | Cincinnati) Sega Game Gear on a Chip | Fall 2012 | 17 / 25

## Custom Test ROM Code Library

We ended up building a library of high level functions to quickly allow new tests to be written

1 void vdp_write_control ( uint8_t value );
2 void vdp_write_data ( uint8_t value );
3 void vdp_set_register ( uint8_t reg , uint8_t value ); 4 void vdp_set_vram_addr ( uint16_t addr );
5 void vdp_set_palette ( uint8_t id , uint16_t color );
6 void set_pattern_fill ( uint16_t id , uint8_t color );
7 void set_tile_to_pattern ( uint8_t x , uint8_t y , uint16_t pattern ); 8 void delay ( uint16_t x );
9 void set_debug ( uint8_t x );
Max Thrun | Samir Silbak (University of | Cincinnati) Sega Game Gear on a Chip | Fall 2012 | 18 / 25

## Custom Test ROM Example

1 | # include < stdint .h >
2 | # include <gg .h >

3
4 | int main () {
5 | uint8_t x = 0;

6
7 | while (1) {
8 | // set register 1 bit 6 to enable display
9 | vdp_set_register (1 , (1 < <6));

10
11 | // set color palette (0 x0BGR )
12 | vdp_set_palette (0 , 0 x0CCC ); | // gray
13 | vdp_set_palette (1 , 0 x000F ); | // red
14 | vdp_set_palette (2 , 0 x00F0 ); | // green

15
16 | // update the debug leds
17 | set_debug (x ++);
18 | }

19
20 | return 0;
21 | }
Max Thrun | Samir Silbak (University of | Cincinnati) Sega Game Gear on a Chip | Fall 2012 | 19 / 25

## Design Overview

Black Box Diagram


Max Thrun | Samir Silbak (University of | Cincinnati) Sega Game Gear on a Chip | Fall 2012 | 20 / 25

## Design Overview

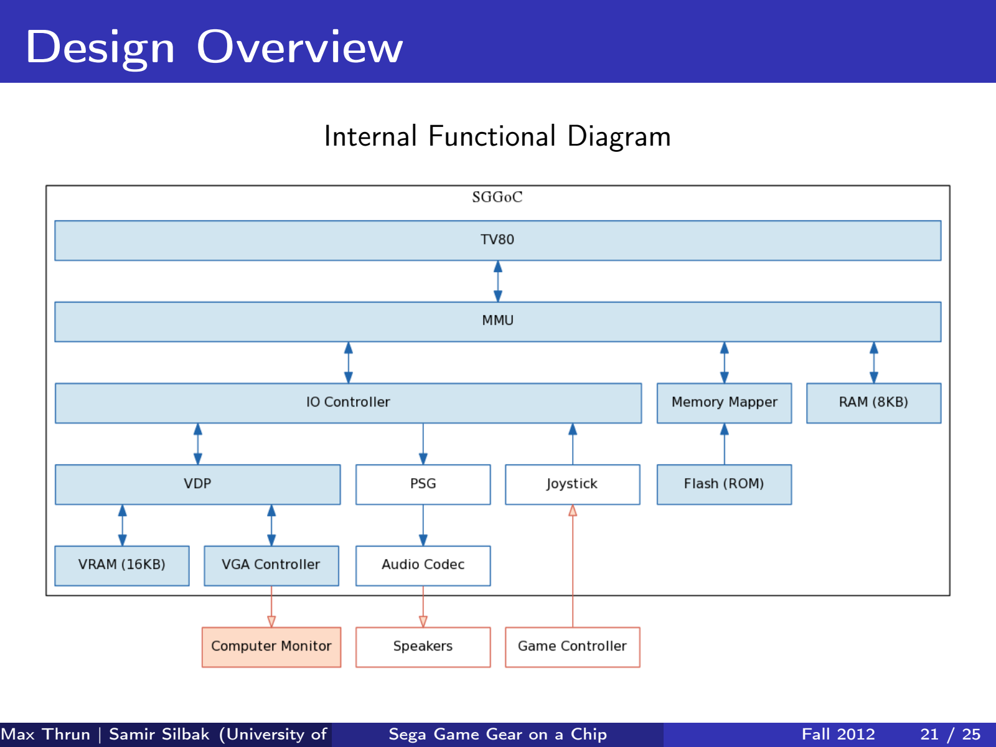
[picture p62: page 30]

Internal Functional Diagram

Max Thrun | Samir Silbak (University of | Cincinnati) Sega Game Gear on a Chip | Fall 2012 | 21 / 25

## Design Overview

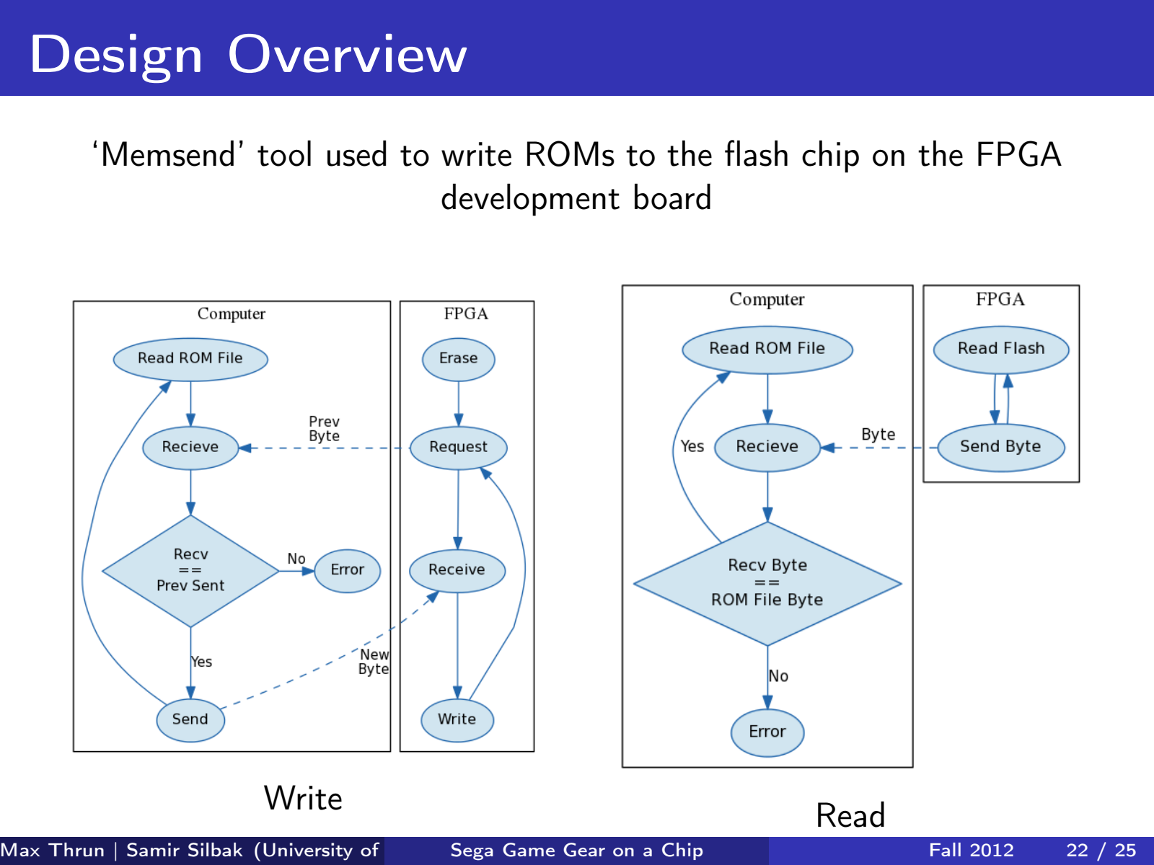
[picture p63: page 31]

‘Memsend’ tool used to write ROMs to the flash chip on the FPGA development board

Write | Read
Max Thrun | Samir Silbak (University of | Cincinnati) Sega Game Gear on a Chip | Fall 2012 | 22 / 25

## Project Limitations

- Tile Corruption - Some tiles are fliped or are the wrong tile ID. Not sure if timing or logic issue yet. Haven’t been able to reproduce with a test ROM yet.
- Missing Features - Currently missing some core functionality such as sprites, controller input, and sound. Each will be added with time.
- Cumbersome ROM Loading - The current process to load a new ROM is cumbersome and takes a long time. It can take 5-10 minutes to flash a multi-megabyte ROM. Loading off an SD card would be much nicer.
Max Thrun | Samir Silbak (University of | Cincinnati) Sega Game Gear on a Chip | Fall 2012 | 23 / 25

## Project Limitations

- Tile Corruption - Some tiles are fliped or are the wrong tile ID. Not sure if timing or logic issue yet. Haven’t been able to reproduce with a test ROM yet.
- Missing Features - Currently missing some core functionality such as sprites, controller input, and sound. Each will be added with time.
- Cumbersome ROM Loading - The current process to load a new ROM is cumbersome and takes a long time. It can take 5-10 minutes to flash a multi-megabyte ROM. Loading off an SD card would be much nicer.
Max Thrun | Samir Silbak (University of | Cincinnati) Sega Game Gear on a Chip | Fall 2012 | 23 / 25

## Project Limitations

- Tile Corruption - Some tiles are fliped or are the wrong tile ID. Not sure if timing or logic issue yet. Haven’t been able to reproduce with a test ROM yet.
- Missing Features - Currently missing some core functionality such as sprites, controller input, and sound. Each will be added with time.
- Cumbersome ROM Loading - The current process to load a new ROM is cumbersome and takes a long time. It can take 5-10 minutes to flash a multi-megabyte ROM. Loading off an SD card would be much nicer.
Max Thrun | Samir Silbak (University of | Cincinnati) Sega Game Gear on a Chip | Fall 2012 | 23 / 25

# Demonstration

Max Thrun | Samir Silbak (University of | Cincinnati) Sega Game Gear on a Chip | Fall 2012 | 24 / 25

# Questions?

Max Thrun | Samir Silbak (University of | Cincinnati) Sega Game Gear on a Chip | Fall 2012 | 25 / 25
