bear24rw/sggoc/doc/block_diagrams/block_diagram_internal.pdf

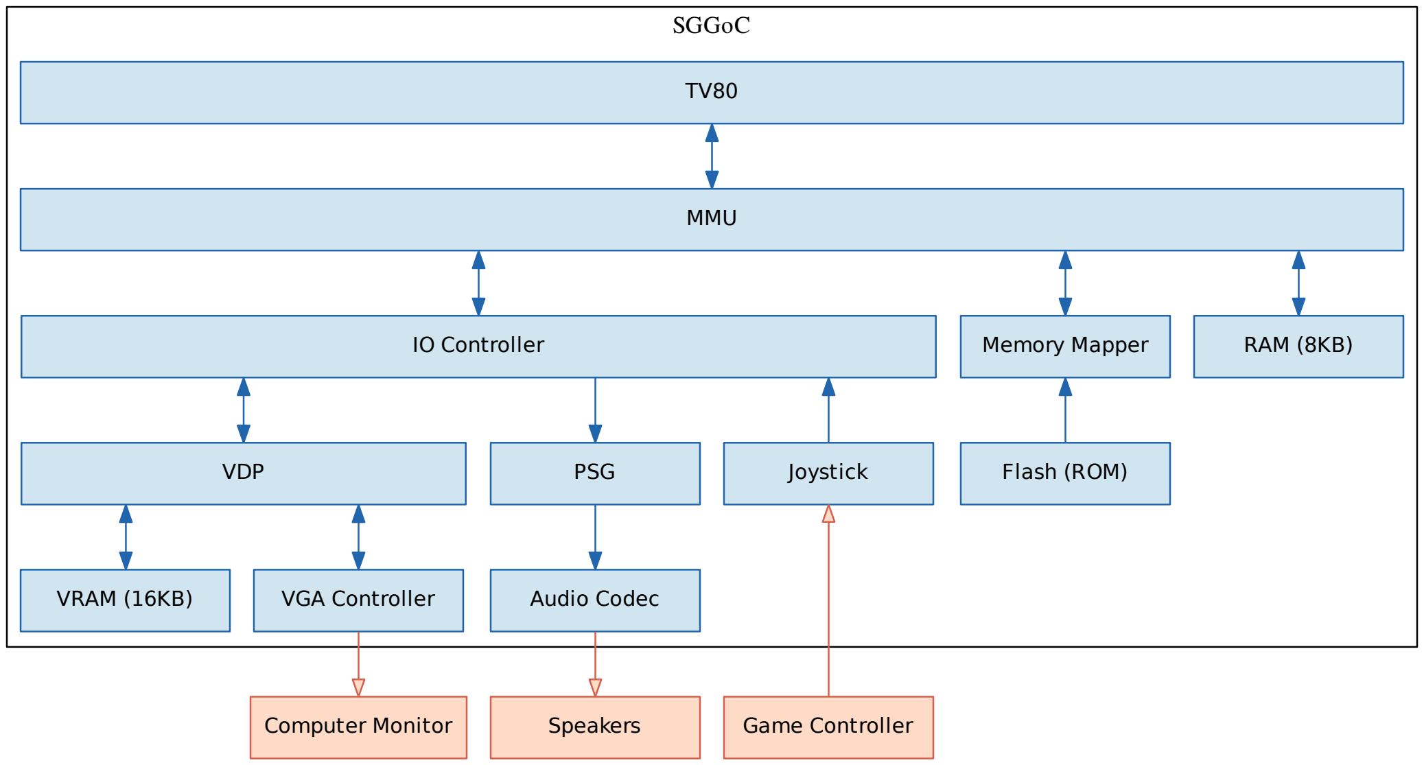
[picture p67: figure]
SGGoC; MMU; IO Controller; Memory Mapper; RAM (8KB); VDP; PSG; Joystick; Flash (ROM); VRAM (16KB); VGA Controller; Computer Monitor; Audio Codec; Speakers; Game Controller
