bear24rw/sggoc/doc/weekly_updates/update_10_20130201.pdf

# Sega Game Gear on a Chip Weekly Update #10

### Max Thrun — Samir Silbak

### February 1, 2013

## Accomplished

- Tested VDP background generator with VRAM dumps and got it working.
- Worked on IO logic between Z80 and VDP.
- Starting looking into making custom ROMs to test specific component individually.

## Planned

- Continue adding documentation and testing strategies to design report.
- Continue work on the VDP and system integration.

## Outstanding Issues

None at this time.

1
