bear24rw/sggoc/doc/weekly_updates/update_04_20121026.pdf

# Sega Game Gear on a Chip Weekly Update #4

### Max Thrun — Samir Silbak

### October 26, 2012

## Accomplished

- Finished final design proposal
- Worked on design history file documents
- Continued work on VGA timing module.

## Planned

- Add more documentation to the ROM flasher.
- Look into the Sega Memory Mapper[1] functionality and start writing a module to reimplement it.
- Finish the VGA timing module.

## Outstanding Issues

None at this time.

## References

[1] http://www.smspower.org/Development/Mappers?from=Development.Mapper

1
