bear24rw/sggoc/doc/block_diagrams/block_diagram_internal_io_ctl.png

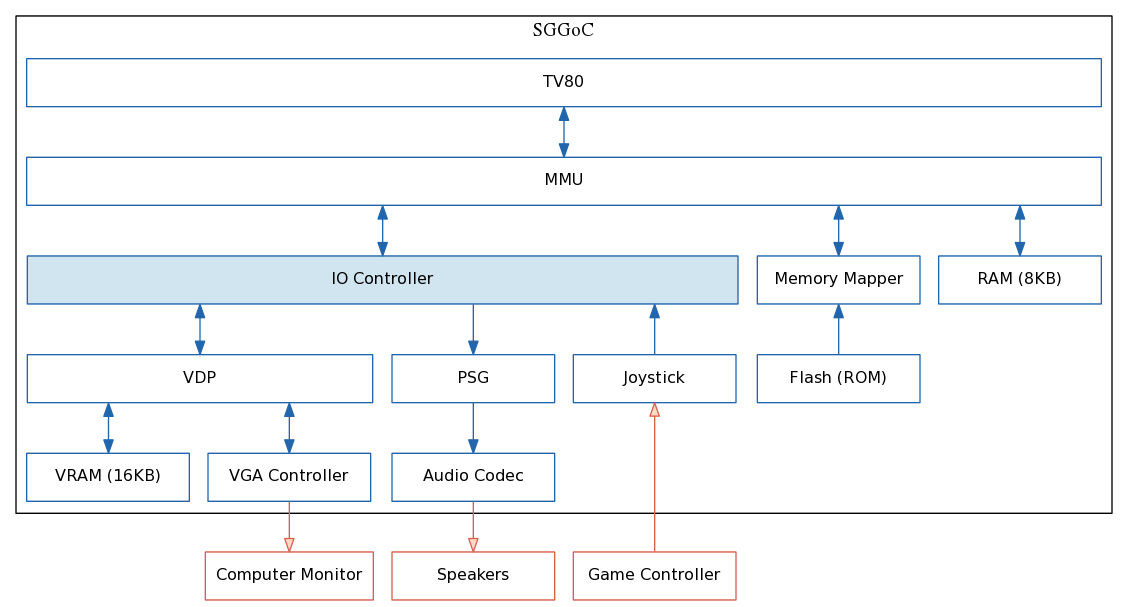
doc/block_diagrams/block_diagram_internal_io_ctl.png
