bear24rw/sggoc/doc/images/gamegear.png

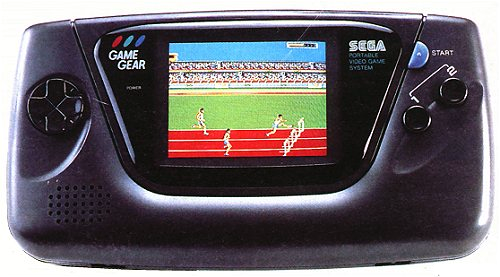
doc/images/gamegear.png
