bear24rw/sggoc/doc/images/uc.png

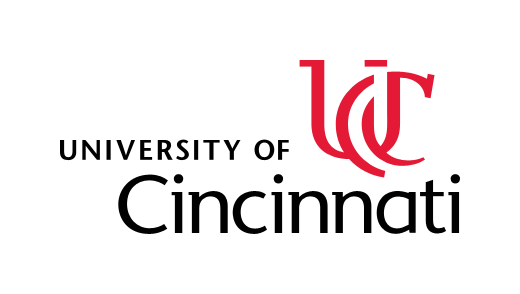
doc/images/uc.png
