bear24rw/sggoc/doc/objective_tree.png

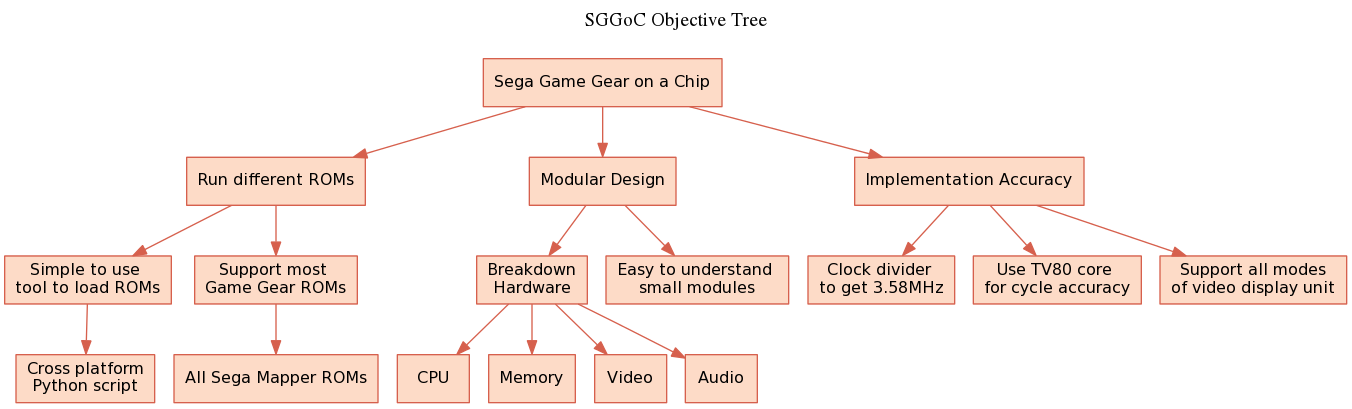
doc/objective_tree.png
