bear24rw/sggoc/ref/emulator_dumps/dump_4/sonic_sega.png

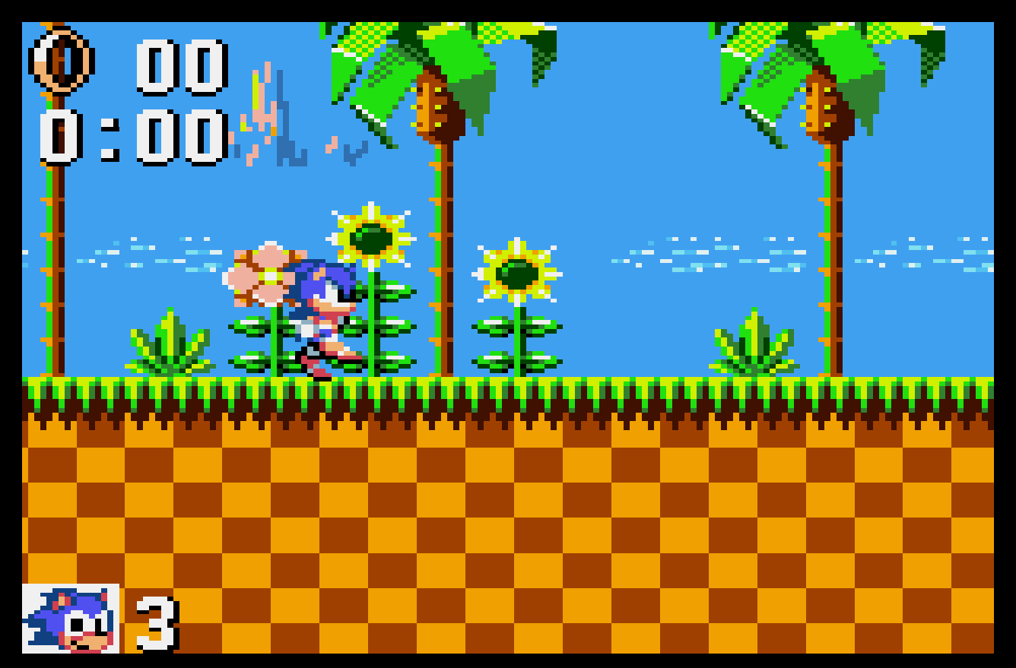
ref/emulator_dumps/dump_4/sonic_sega.png
