bear24rw/sggoc/doc/images/flash_core.pdf

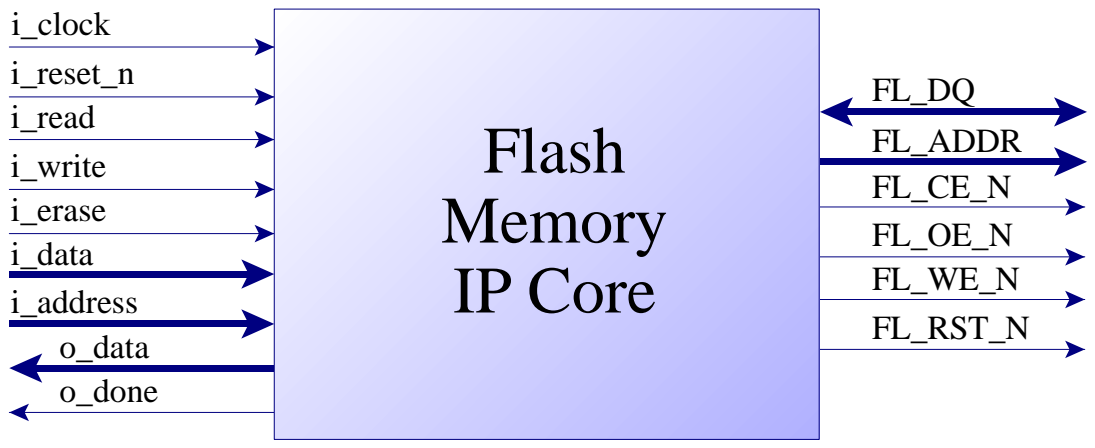
[picture p74: page 1]
i_clock i_reset_n; i_address; i_data; i_read i_write i_erase; o_data o_done; FL_ADDR; FL_CE_N FL_OE_N FL_WE_N FL_RST_N; Flash Memory IP Core
