bear24rw/sggoc/ref/altera_up_flash_memory/doc/fig_flash_avalon_interface.pdf

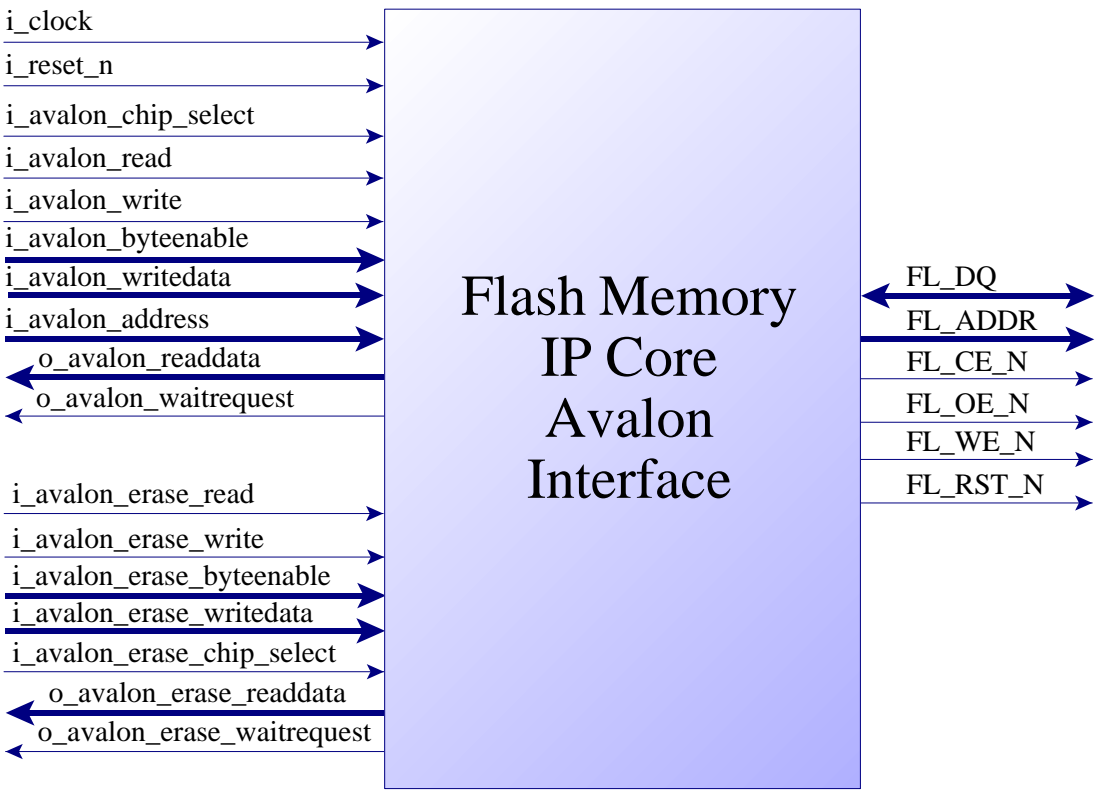
[picture p75: page 1]
i_clock i_reset_n; i_avalon_address; i_avalon_writedata; i_avalon_read i_avalon_write i_avalon_byteenable; o_avalon_readdata o_avalon_waitrequest; FL_ADDR; FL_CE_N FL_OE_N FL_WE_N FL_RST_N; i_avalon_erase_writedata; i_avalon_erase_read i_avalon_erase_write i_avalon_erase_byteenable; o_avalon_erase_readdata o_avalon_erase_waitrequest; i_avalon_chip_select; i_avalon_erase_chip_select; Flash Memory IP Core Avalon Interface
