bear24rw/sggoc/fpga/sggoc/verilog/rtl/vdp.v

/***************************************************************************
 *   Copyright (C) 2012 by Max Thrun                                       *
 *   Copyright (C) 2012 by Samir Silbak                                    *
 *                                                                         *
 *   (SSGoC) Sega Game Gear on a Chip                                      *
 *                                                                         *
 *   This program is free software; you can redistribute it and/or modify  *
 *   it under the terms of the GNU General Public License as published by  *
 *   the Free Software Foundation; either version 2 of the License, or     *
 *   (at your option) any later version.                                   *
 *                                                                         *
 *   This program is distributed in the hope that it will be useful,       *
 *   but WITHOUT ANY WARRANTY; without even the implied warranty of        *
 *   MERCHANTABILITY or FITNESS FOR A PARTICULAR PURPOSE.  See the         *
 *   GNU General Public License for more details.                          *
 *                                                                         *
 *   You should have received a copy of the GNU General Public License     *
 *   along with this program; if not, write to the                         *
 *   Free Software Foundation, Inc.,                                       *
 *   51 Franklin St, Fifth Floor, Boston, MA 02110-1301, USA.              *
 ***************************************************************************/

module vdp(
    input clk,
    input rst,

    input               control_wr,
    input               control_rd,
    input      [7:0]    control_i,
    output reg [7:0]    control_o,

    input               data_wr,
    input               data_rd,
    input      [7:0]    data_i,
    output reg [7:0]    data_o,

    output              irq_n,

    output [7:0]        v_counter,
    output [7:0]        h_counter,

    output reg [8:0]    pixel_x,
    output reg [8:0]    pixel_y,

    output [3:0]        color_r,
    output [3:0]        color_g,
    output [3:0]        color_b
);

    // ----------------------------------------------------
    //                      REGISTERS
    // ----------------------------------------------------

    reg [7:0] register [0:10];

    initial begin
        register[0] = 'h00;    // mode control 1
        register[1] = 'h00;    // mode control 2
        register[2] = 'h0e;    // name table base address (0x3800)
        register[3] = 'h00;    // color table base address
        register[4] = 'h00;    // background pattern generator base address
        register[5] = 'h7e;    // sprite attribute table base address (0x3F00)
        register[6] = 'h00;    // sprite pattern generator base address
        register[7] = 'h00;    // overscan/backdrop color
        register[8] = 'h00;    // background X scroll
        register[9] = 'h00;    // background Y scroll
        register[10] = 'hff;   // line counter
    end

    wire [2:0] name_table             = register[2][3:1];
    wire [5:0] sprite_attribute_table = register[5][6:1];
    wire       sprite_pattern_table   = register[6][2];

    wire        irq_vsync_en     = register[1][5];
    wire        irq_line_en      = register[0][4];
    wire [7:0]  scroll_x         = register[8];
    wire [7:0]  scroll_y         = register[9];
    wire        disable_x_scroll = register[0][6];
    wire        disable_y_scroll = register[0][7];
    wire        m1               = register[1][4];
    wire        m2               = register[0][1];
    wire        m3               = register[1][3];
    wire        m4               = register[0][2];
    wire        blank            = !register[1][6];
    wire [3:0]  overscan_color   = register[7][3:0];
    wire        sprite_shift     = register[0][3];
    wire        sprite_size      = register[1][1];

    // m4: 1 = use mode 4, 0 = use tms modes (selected with m1 m2 m3)
    // m2: 1 = m1/m3 change screen height in mode 4
    // m1: 1 = 224 lines if m2=1
    // m3: 1 = 240 lines if m2=1

    wire mode_4_192 = (m4 && !m2) || (m4 && m2 && !m1 && !m3);

    // ----------------------------------------------------
    //                      VRAM
    // ----------------------------------------------------

    reg  [13:0] vram_addr_a;
    wire [ 7:0] vram_do_a;
    reg  [ 7:0] vram_di_a;
    wire        vram_we_a;

    wire [13:0] vram_addr_b = (pixel_x >= 256) ? sprite_vram_addr : background_vram_addr;
    wire [ 7:0] vram_do_b;

    vram vram(
        // port a = cpu side
        .clk_a(~clk),
        .we_a(vram_we_a),
        .addr_a(vram_addr_a),
        .do_a(vram_do_a),
        .di_a(vram_di_a),

        // port b = vdp side
        .clk_b(~clk),
        .we_b(1'b0),
        .addr_b(vram_addr_b),
        .do_b(vram_do_b),
        .di_b(8'b0)
    );

    // ----------------------------------------------------
    //                      CRAM
    // ----------------------------------------------------

    reg [7:0] CRAM [0:63];

    // ----------------------------------------------------
    //                      BACKGROUND
    // ----------------------------------------------------

    wire [ 5:0] background_color;
    wire        background_priority;
    wire [13:0] background_vram_addr;

    vdp_background vdp_background(
        .clk(clk),
        .pixel_x(pixel_x),
        .pixel_y(pixel_y),
        .scroll_x(scroll_x),
        .scroll_y(scroll_y),
        .disable_x_scroll(disable_x_scroll),
        .disable_y_scroll(disable_y_scroll),
        .name_table(name_table),
        .vram_addr(background_vram_addr),
        .vram_data(vram_do_b),
        .color(background_color),
        .priority_(background_priority)
    );

    // ----------------------------------------------------
    //                      SPRITES
    // ----------------------------------------------------

    wire [ 5:0] sprite_color;
    wire [13:0] sprite_vram_addr;
    wire        sprite_overflow;
    reg         sprite_overflow_flag;

    vdp_sprites vdp_sprites(
        .clk(clk),
        .pixel_x(pixel_x),
        .pixel_y(pixel_y),
        .vram_addr(sprite_vram_addr),
        .vram_data(vram_do_b),
        .attribute_table(sprite_attribute_table),
        .pattern_table(sprite_pattern_table),
        .overflow(sprite_overflow),
        .shift(sprite_shift),
        .size(sprite_size),
        .color(sprite_color)
    );

    always @(posedge clk) begin
        if (sprite_overflow) begin
            sprite_overflow_flag <= 1;
        end else if (control_rd) begin
            sprite_overflow_flag <= 0;
        end
    end

    // ----------------------------------------------------
    //                    OUTPUT COLOR
    // ----------------------------------------------------

    wire [5:0] color = (sprite_color[4:1] != 0 && !background_priority) ? sprite_color : background_color;

    assign color_r = blank ? 4'h0 : CRAM[color][3:0];
    assign color_g = blank ? 4'h0 : CRAM[color][7:4];
    assign color_b = blank ? 4'h0 : CRAM[color+1][3:0];

    // ----------------------------------------------------
    //                    COUNTERS
    // ----------------------------------------------------

    // NTSC 256x192
    // each scanline = 342 pixels
    // each frame    = 262 scanlines

    // counters read by the cpu have weird jumps:
    // v: 00-DA, D5-FF
    // h: 00-93, E9-FF

    assign v_counter = pixel_y <= 9'hda ? pixel_y[7:0]
                                        : pixel_y[7:0] - 8'd6;

    assign h_counter = pixel_x[8:1] <= 8'h93 ? pixel_x[8:1]
                                             : pixel_x[8:1] + 8'd85;

    // we need extra time at the end of the scanline for the sprite engine to
    // finish building the sprite buffers for the next line. 32 is just an
    // estimate, we should figure out the actual number of figure out what the
    // actually proper timing is for all this stuff.
    reg [7:0] scanline_delay = 0;
    always @(posedge clk) begin
        if (pixel_x == 341) begin
            if (scanline_delay == 32) begin
                scanline_delay <= 0;
                pixel_x <= 0;
                pixel_y <= pixel_y == 261 ? 0 : pixel_y + 1;
            end else begin
                scanline_delay <= scanline_delay + 1;
            end
        end else begin
            pixel_x <= pixel_x + 1;
        end
    end

    // ----------------------------------------------------
    //                       IRQ
    // ----------------------------------------------------

    // frame interrupt

    reg interrupt_flag = 0;

    // active area is 192 lines (0-191)
    always @(posedge clk) begin
        if (pixel_y == 192 && pixel_x == 0) begin
            interrupt_flag <= 1;
        end else if (control_rd) begin
            interrupt_flag <= 0;
        end
    end

    wire irq_vsync_pending = (interrupt_flag && irq_vsync_en);

    assign irq_n = !irq_vsync_pending;

    // ----------------------------------------------------
    //                  CONTROL LOGIC
    // ----------------------------------------------------

    `define CODE_VRAM_READ  2'b00
    `define CODE_VRAM_WRITE 2'b01
    `define CODE_REG_WRITE  2'b10
    `define CODE_CRAM_WRITE 2'b11

    reg is_second_byte = 0;
    reg [7:0] first_byte = 0;
    reg [1:0] code = 0;
    reg [13:0] ram_addr = 0;
    reg [7:0] cram_latch = 0;

    //
    // CONTROL / DATA EDGE DETECTION
    //

    // keep track of the last state so we can detect edges
    reg last_control_rd = 0;
    reg last_control_wr = 0;
    reg last_data_rd = 0;
    reg last_data_wr = 0;

    always @(posedge clk) begin
        if (rst) begin
            last_control_rd <= 0;
            last_control_wr <= 0;
            last_data_rd <= 0;
            last_data_wr <= 0;
        end else begin
            last_control_rd <= control_rd;
            last_control_wr <= control_wr;
            last_data_rd <= data_rd;
            last_data_wr <= data_wr;
        end
    end

    wire control_rd_edge = control_rd && !last_control_rd;
    wire control_wr_edge = control_wr && !last_control_wr;
    wire data_rd_edge    = data_rd    && !last_data_rd;
    wire data_wr_edge    = data_wr    && !last_data_wr;

    // vram write enable when we're not writing to cram
    assign vram_we_a = data_wr && (code != `CODE_CRAM_WRITE);

    always @(posedge clk) begin
        if (rst) begin
            register[0] <= 'h00;    // mode control 1
            register[1] <= 'h00;    // mode control 2
            register[2] <= 'h0e;    // name table base address (0x3800)
            register[3] <= 'h00;    // color table base address
            register[4] <= 'h00;    // background pattern generator base address
            register[5] <= 'h7e;    // sprite attribute table base address (0x3F00)
            register[6] <= 'h00;    // sprite pattern generator base address
            register[7] <= 'h00;    // overscan/backdrop color
            register[8] <= 'h00;    // background X scroll
            register[9] <= 'h00;    // background Y scroll
            register[10] <= 'hff;   // line counter
            is_second_byte <= 0;
            data_o <= 8'h0;
        end else begin
            if (control_wr_edge) begin
                is_second_byte <= !is_second_byte;
            end else if (control_rd_edge || data_wr_edge || data_rd_edge) begin
                is_second_byte <= 0;
            end

            if (control_wr_edge) begin
                if (is_second_byte) begin
                    code <= control_i[7:6];
                    case (control_i[7:6])
                        `CODE_REG_WRITE:
                            register[control_i[3:0]] <= first_byte;
                        `CODE_VRAM_READ,
                        `CODE_VRAM_WRITE,
                        `CODE_CRAM_WRITE:
                            ram_addr <= {control_i[5:0], first_byte};
                    endcase
                end else begin
                    first_byte <= control_i;
                end
            end else if (control_rd_edge) begin
                control_o <= { interrupt_flag, sprite_overflow_flag, 1'b0, 5'b0 };
            end else if (data_rd_edge) begin
                data_o <= vram_do_a;
                ram_addr <= ram_addr + 1;
            end else if (data_wr_edge) begin
                ram_addr <= ram_addr + 1;
                if (code == `CODE_CRAM_WRITE) begin
                    // actual write only takes place on the odd address
                    if (vram_addr_a[0] == 0) begin
                        cram_latch <= data_i;
                    end else begin
                        CRAM[ram_addr[5:0]-1] <= cram_latch;
                        CRAM[ram_addr[5:0]  ] <= data_i;
                    end
                end else begin
                    vram_di_a <= data_i;
                    data_o <= data_i;
                end
            end

            vram_addr_a <= ram_addr;
        end
    end

endmodule
