bear24rw/sggoc/(commit log)

2012-10-05 added reference material
2012-10-13 [rom_flasher] found a better uart module that actually syncronizes the rx line
2012-10-13 [rom_flasher] switched out the old uart
2012-10-13 [rom_flasher] track synth makefile
2012-10-13 [rom_flasher] add missing FL_CE_N pin to qsf
2012-10-13 [rom_flasher] add flash core to top / add states to handle it / show status on seven seg and leds
2012-10-15 [rom_flasher] add readback states and control switch to dump rom back to computer to make sure it's correct
    [top.v]
2012-11-06 [verilog] fixed vga timing module
    [vga_timing.v]
2012-11-06 [verilog] fixed top to display red box
    [top.v]
2013-01-13 [vga] fixed scan_x scan_y naming / added pixel_xy outputs / color test pattern
    [top.v, vga_timing.v]
2013-02-08 [vdp] load RAM via uart
2013-02-08 [vga_vdp] tighter vga timings
    [top.v, vga_timing.v]
2013-02-08 [sggoc] don't track summary logs
2013-02-11 [sggoc] make sure interrupts are disabled (for now)
2013-02-12 [sggoc] handle reset in cartridge
    [cartridge.v]
2013-02-12 [sggoc] switch clk_div to use non blocking assignments
2013-02-12 [sggoc] fix ram_addr size in mmu port list
    [mmu.v]
2013-02-12 [sggoc] change clock speed to 10hz for now. counter test rom doesn't seem to work at lower speeds?
    [top.v]
2013-02-12 [sggoc] fix card_addr width
    [top.v]
2013-02-12 [sggoc] hookup red leds to io port 0x01
2013-02-12 [sggoc] fixed cartridge flash logic. It wasn't wasn't waiting for the read cycle to end before going back and getting another byte. It could have read multiple bytes of flash per z80 read cycle befor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
    [cartridge.v]
2013-02-13 [sggoc] fix bg_color bitwidth
    [vdp.v]
2013-02-13 [sggoc] fix vdp <-> z80 control logic. palette test works now.
    [vdp.v]
2013-02-13 [sggoc] increase clock speed / set green leds back to z80 status lines
2013-02-25 [osmose] fix ::read() not found compile error
    [Joystick.h]
2013-02-26 [sggoc] switch back to regular clock speed (should probably make this switchable realtime)
2013-02-26 [vdp] increment vram address on next clock cycle so we have time to write the data to the current address first
2013-02-27 moved uart.v to sggoc project
2013-02-27 [sggoc] added debug module to send memory access addresses out the uart
2013-02-27 [osmose] don't track makefile
2013-02-28 [osmose] added print_log function (currently while(1) on first CRAM write to debug for now)
2013-02-28 [osmose] print_log files
2013-02-28 [osmose] more print_log
2013-02-28 [osmose] print_log formatting
2013-03-02 [vdp] fixed irq logic
    [vdp.v]
2013-03-02 [vdp] correct color palette displays on fpga
    [vdp.v]
2013-03-03 [osmose] print_logs
2013-03-04 [sggoc/osmose] match cram prints
2013-03-06 [sggoc] fixed vdp counters (tiles test rom works again now)
    [vdp.v]
2013-03-06 [osmose] print_log physical rom addr
2013-03-09 [vdp] fixed bit width
    [vdp.v]
2013-03-10 [sggoc] made mem_mapper reset non blocking
    [mem_mapper.v]
2013-03-10 [vdp] initialize registers to correct default values
    [vdp.v]
2013-03-12 [sggoc] set led 6 to z80_wait_n
2013-03-12 [sggoc] track mem_mapper and sggoc testbenches
2013-03-12 [vdp] drive z80 side of vram with vga_clk so make it a single-clocked ram. this allows us to remove the VERIFIED qsf line and prove that the dual port ram errata isn't causing issues
    [vdp.v]
2013-03-12 [vdp] move register reset up to where they are defined
    [vdp.v]
2013-03-12 Revert "[vdp] move register reset up to where they are defined"
    Can't assign register[] in more than one place
    This reverts commit 787063dc845ab4eedfec5f9ac7a0b201d4932aa0.
    [vdp.v]
2013-03-12 [vdp] wires for control and data positive edge
2013-03-12 [vdp] change frame interrupt line to decimal to make it more obvious to understand
2013-03-12 [sggoc] fixed vdp.clk_50 in sggoc testbench
    [sggoc_tb.v]
2013-03-12 [vdp] added line interrupt
2013-03-12 [vdp] made assignments explicit wires
2013-03-13 [test_roms] fixed vram test
    [main.c]
2013-03-14 [vdp] give priority to z80 on clearing the interrupt flag
2013-03-14 [vdp] crop screen to correct size
    [vdp.v]
2013-03-14 [vdp] fix crop location
    [vdp.v]
2013-03-14 [vdp] indicate error if we're not in mode 4 192 lines
    [vdp.v]
2013-03-14 [vdp] check for mode error last so the red doesn't cover up everything
    [vdp.v]
2013-03-14 [sggoc] fixed io reset line in sggoc_tb
    [sggoc_tb.v]
2013-03-15 [vdp] make mode error background dark red so we can still see red cram write lines
    [vdp.v]
2013-03-15 [osmose] disable print_log for now
2013-03-16 [vdp_bg] fixed y scroll, but there is still some corruption for scrolling
    [vdp_background.v]
2013-03-17 [vdp_bg] y scroll works correctly now
    [vdp_background.v]
2013-03-20 [vdp] draw a frame outlining the ntsc frame
2013-03-20 [vdp] frame interrupt on the last line after active display area
2013-03-20 [vdp] fixed syntax error and made vdp counter output wires
    [vdp.v]
2013-03-20 [vdp] fix ntsc outline
    [vdp.v]
2013-05-25 [vga] vga timing is fixed now
    [vga_timing.vhd]
2013-05-26 [top] initialized reset switch before begin block and removed negative edge reset switch
2013-05-27 [sggoc] removed negative edge reset signal
    [top.vhd]
2013-06-15 [top] replaced verilog version of T80 with VHDL version
    [top.vhd]
2013-06-15 [vdp_bg] added default case in case statement
2013-06-16 [top] fixed z80 mem/io rd/wr assignments
    [top.vhd]
2013-06-16 [vdp] fixed line counter arithmatic and added control_rd condition
    [vdp.vhd]
2013-07-22 [mem_mapper] fixed width length
    [mem_mapper.vhd]
2013-07-22 [vdp_bg] took signals out from process and fixed case statement
    [vdp_background.vhd]
2013-07-23 [vdp] fixed line_counter arithmetic
    [vdp.vhd]
2013-07-23 [vdp] fixed v_counter to include full length of pixel_y
    [vdp.vhd]
2013-07-23 [vga_timing] check for scan_y was correct, ignore previous commit
    [vga_timing.vhd]
2013-07-24 [mem_mapper] added error case in mux
    [mem_mapper.vhd]
2013-07-24 [vdp] removed unnecessary state for frame interrupt
2021-11-29 rtl: syncronous reset only
    [io.v, mem_mapper.v, vdp.v]
2021-11-29 rtl: comment out a bunch of , try to fix some width mismatches, add (unused) bank_control register to mem_mapper, fix namings of some things
    [io.v, mem_mapper.v, vdp.v, vdp_background.v, vram.v]
2021-11-29 rtl: move sggoc core to its own module, need to update top module to instantiate this instead and do the board specific stuff there
2021-11-29 rtl: fix vram port a clock, this fixes a ton of corruption
    [vdp.v]
2021-12-01 cleanup and fix h/v counters
    [sggoc.v, vdp.v]
2021-12-01 fix lcd display area being off by two pixels by removing two needed clock cycles
    [vdp.v, vdp_background.v]
2021-12-01 initial (pretty broken) sprite support
    [vdp.v, vdp_background.v, vdp_sprites.v]
2021-12-02 re-enabled width warning and fix all of them
    [mem_mapper.v, vdp.v, vdp_background.v, vdp_sprites.v]
2021-12-02 draw vram as hex editor instead of image because thats much more useful. sleep when paused so we dont burn cpu
    [vdp.v, vdp_sprites.v]
