bear24rw/sggoc/(notices)

Notices in the files:
tools/Osmose-0-9-96-QT/OsmoseGUI.h:
Osmose is free software: you can redistribute it and/or modify
the Free Software Foundation, either version 3 of the License, or
any later version.
fpga/sggoc/verilog/rtl/uart.v:
the Free Software Foundation, version 3 of the License.
